prathiitsharma-cmd/Pintle-Injector-Re-Design/docs/design-guide/parts-list.jpeg

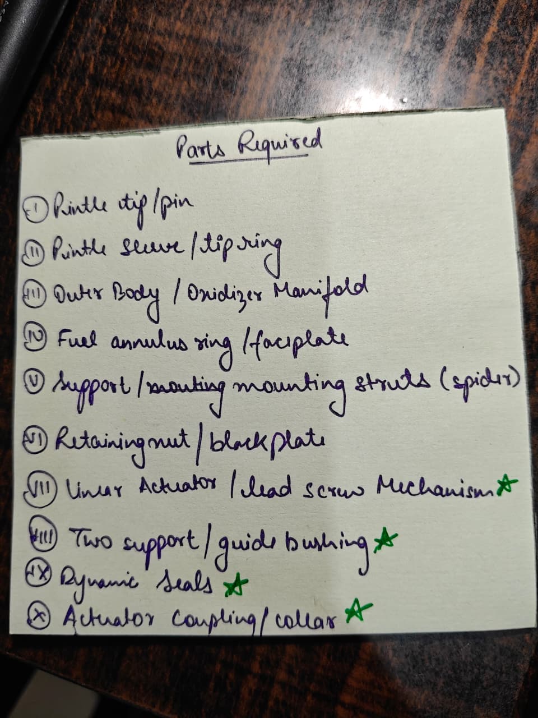
docs/design-guide/parts-list.jpeg
