prathiitsharma-cmd/Pintle-Injector-Re-Design/analysis/notes/pintle_injector_complete_reference.md

# Movable Pintle Injector with Spiral+Vane Manifold — Complete Project Reference

> **Project Status:** Design + CFD Phase (No Manufacturing Planned)  
> **Last Updated:** 2026-07-23  
> **Design Point:** LOX/LCH4, O/F = 3.2, Pc = 20 bar, Thrust = 750 N, Ae/At = 5

---

## Table of Contents

1. [Executive Summary](#1-executive-summary)
2. [Problem Statement & Research Novelty](#2-problem-statement--research-novelty)
3. [Literature Validation](#3-literature-validation)
4. [The 13-Phase Master Plan (with Gaps)](#4-the-13-phase-master-plan-with-gaps)
5. [Fluid Mechanics Refresher](#5-fluid-mechanics-refresher)
6. [Spiral Manifold Scale-Effect Validation](#6-spiral-manifold-scale-effect-validation)
7. [MATLAB Sizing Script](#7-matlab-sizing-script)
8. [NASA CEA Analysis & Thermodynamic Properties](#8-nasa-cea-analysis--thermodynamic-properties)
9. [Design Parameters & Baseline Geometry](#9-design-parameters--baseline-geometry)
10. [SolidWorks Modeling Workflow](#10-solidworks-modeling-workflow)
11. [CFD Strategy](#11-cfd-strategy)
12. [References](#12-references)

---

## 1. Executive Summary

This project investigates whether a **spiral (volute) manifold with turning vanes** can improve spray uniformity across the throttle range of a movable pintle injector, compared to a conventional single side-inlet feed.

**Scope:** Cold-flow water demonstrator, 3:1 throttling ratio, oxidizer-centered pintle.  
**Novelty:** No direct precedent exists in open literature for applying a tapering spiral+vane manifold specifically to a pintle injector's annular fuel passage. The concept borrows from Francis turbine volute design and the Saturn V F-1 turbine exhaust manifold.

**Verdict:** The spiral concept is **viable at millimeter scale** provided boundary layer thickness remains below ~30% of channel height. Hand calculations and MATLAB sizing confirm the concept passes the scale-effect gate.

---

## 2. Problem Statement & Research Novelty

### 2.1 The Core Problem

Side-fed inlets impart tangential momentum that causes **torsional/swirling flow** inside the manifold cavity. For a movable pintle, the annular gap geometry changes continuously during throttling, so any swirl in the approach flow is exposed differently at every throttle position. This creates:

- Circumferentially asymmetric spray cones
- Combustion efficiency variation across throttle range
- Potential combustion instability
- Uneven thermal loading on chamber walls

### 2.2 Literature Confirmation

| Source | Finding |
|---|---|
| **Erkal (METU, 2019)** | Side-fed inlet created asymmetric flow requiring a 72-hole flow stabilizer. Final design used two mountings to stabilize torsional flow. |
| **DiVA Thesis (2023)** | Radial inlets create angular velocity in annular orifice; mitigated by distribution plate with holes. Position/size "usually decided by engineering experience." |
| **DLR Cold-Flow (2023)** | Used **two side inlets** to generate uniform injection pressure — tacit admission single side inlet is insufficient. |
| **NASA Throttling Report (2009)** | Low-frequency oscillations during LMDE throttling linked to injection state instability and manifold dynamics. |
| **Zhao et al. (2022)** | Review in *Acta Astronautica* explicitly flags thrust regulation with adjustable pintle injectors as unresolved: "this remains challenging." |

### 2.3 Novelty Assessment

| Claim | Validation |
|---|---|
| Side-fed swirl is real | ✅ Confirmed by multiple theses and patents |
| Movable pintle exacerbates it | ✅ Confirmed by NASA throttling studies |
| Spiral+vane as solution | ✅ **No direct precedent in propellant injectors.** Closest analogs: Saturn V F-1 turbine exhaust manifold (flight-proven), refrigeration patent US7,806,171, hypergolic patent US9,404,441. |
| Cold-flow validation correlates | ✅ Confirmed by METU thesis and MDPI 2026 study |

**Rating:** Genuinely novel at the project/research level. Cross-domain transfer (turbine volute → propellant injector) is scientifically valid and explicitly addresses a gap flagged in recent review literature.

---

## 3. Literature Validation

### 3.1 Current State-of-the-Art for Manifold Uniformity

1. **Perforated distribution plates** (METU 72-hole design, DiVA thesis) — empirical, adds pressure drop, not throttle-adaptive.
2. **Dual side inlets** (DLR 2023) — simple, cancels net swirl but creates standing waves.
3. **Shower-head / multi-prong diffusers** (US9,404,441) — discrete, machining-intensive.

**Our approach is distinct:** Continuous (not discrete), throttle-adaptive (geometry doesn't change with pintle position), and theoretically derived (area ∝ remaining flow) rather than empirical.

### 3.2 Key Patents & Precedents

| Patent / Source | Relevance |
|---|---|
| **US3,699,772** (Elverum/TRW, 1972) | Original pintle injector patent |
| **US20090007543A1** (SpaceX) | Pintle injector tip with active cooling |
| **US7,077,102** | Dual inlet port for IC engine — tangential ducts at 180° opposition, opposite swirl |
| **US7,806,171** | Spiral inlet manifold diminishing in cross-section — refrigeration precedent |
| **US9,404,441** | Multi-prong diffuser for hypergolic engine — discrete uniform distribution |
| **Saturn V F-1 Turbine Exhaust** | Torus of decreasing area + splitter plates + exit vanes — closest flight-proven analog |
| **ASME Turbomachinery (2023)** | Deswirl vane ring after dump diffuser — validates vane swirl removal in annular flows |

### 3.3 Recent Research Papers

| Paper | Key Finding |
|---|---|
| Zhao et al., *Acta Astronautica*, 2022 | Review flags throttling + stability as open challenge |
| Lee et al., *IJASS*, 2024 | Effect of flow passage area ratio on double slit-type pintle injector |
| MDPI *Aerospace*, Jan 2026 | "Water cold flow testing provides cost-effective spray characterization, correlating well with hot fire behavior." |
| DiVA Thesis, 2023 | Suggested cold-flow; documented side-inlet swirl issue |
| KAIST Supercritical LOX Study | LOX boiling in manifold caused TMR fluctuations and rough combustion |

---

## 4. The 13-Phase Master Plan (with Gaps)

### Original Plan

| Phase | Content |
|---|---|
| 0 | Foundational decisions |
| 1 | Performance & flow calculations |
| 2 | Core pintle/sleeve geometry |
| 3 | Throttling range & mechanism |
| 4 | Manifold redesign: spiral cavity |
| 5 | Manifold redesign: turning vanes |
| 6 | Baseline design (control case) |
| 7 | SolidWorks modeling |
| 8 | Verification |
| 9 | Manufacturing |
| 10 | Test setup |
| 11 | Testing |
| 12 | Analysis |
| 13 | Documentation |

### Five Critical Gaps Identified

#### Gap 1: O/F Ratio Control During Throttling (Missing from ALL phases)
**Risk:** When the pintle moves, it changes oxidizer AND fuel flow areas simultaneously. O/F ratio drifts across throttle range unless compensated.

**Fix:** Add to Phase 3:
- [ ] Analyze O/F ratio drift vs. Laod for your geometry
- [ ] Decide passive (matched area ratios) or active (cavitating venturi) control
- [ ] If cold-flow only: document as out-of-scope but flag for hot-fire transition

#### Gap 2: Scale-Effect / Boundary Layer Validation (Missing from Phase 4)
**Risk:** At millimeter scale, boundary layers may fill the channel, invalidating the inviscid taper assumption.

**Fix:** Add to Phase 4:
- [ ] Calculate hydraulic diameter and Re for spiral channel
- [ ] Estimate boundary layer thickness (δ ~ 5x/√Re_x)
- [ ] Validate δ < 0.2×channel height; if not, redesign
- [ ] Check laminar vs. turbulent regime in spiral channel

#### Gap 3: Uncertainty Quantification (Missing from Phases 10–12)
**Risk:** No metric for what "good" repeatability means.

**Fix:** Add to Phase 10:
- [ ] Define uncertainty propagation for flow meters (±3%), pressure transducers (±0.5%)
- [ ] Set minimum sample size (n ≥ 5 per condition)
- [ ] Define repeatability metric: CoV of spray half-angle < 5%

#### Gap 4: Transient Throttling Test Protocol (Missing from Phase 11)
**Risk:** NASA found oscillations during throttling *transitions*, not steady-state.

**Fix:** Add to Phase 11:
- [ ] Include transient tests: sweep pintle position at constant speed
- [ ] Characterize hysteresis or delay in spray response
- [ ] Check for dynamic flow separation in spiral during acceleration

#### Gap 5: Manufacturing Feasibility Gate (Missing from Phase 6/9)
**Risk:** Spiral cavity may not be printable at required resolution.

**Fix:** Add to Phase 6:
- [ ] Consult manufacturer on minimum feature size
- [ ] Print test coupon of spiral section; inspect via CT scan or sectioning
- [ ] Fallback design: discrete multi-prong diffuser if printing fails

### Other Minor Gaps

| Gap | Location | Fix |
|---|---|---|
| Skip distance (L_skip) optimization | Phase 2 | Add: L_skip = Dp per engineering experience |
| Seal leakage quantification | Phase 3 | Leakage test at max pressure before assembly |
| Vibration / structural mode check | Phase 3 | Check natural frequency of pintle rod |
| Data management plan | Phase 13 | Raw data repo, version-controlled CAD, analysis scripts |

---

## 5. Fluid Mechanics Refresher

### Tier 0: Properties (15 min)

| Property | Symbol | Why It Matters |
|---|---|---|
| Density | ρ | Determines mass flow through a given hole |
| Dynamic viscosity | μ | Internal resistance; decides laminar vs. turbulent |
| Kinematic viscosity | ν = μ/ρ | The number you plug into Reynolds number |

### Tier 1: Kinematics

- **Streamlines / Streamtubes:** Your spiral manifold IS a streamtube that wraps around a circle.
- **Steady vs. Unsteady:** Fixed throttle = steady; moving pintle = unsteady.

### Tier 2: Conservation Laws

#### 5.1 Conservation of Mass (Continuity)
$$\dot{m} = \rho A V = \text{constant}$$

For incompressible flow: **A₁V₁ = A₂V₂**

**This is the entire mathematical basis of your spiral manifold.** The spiral cross-section A(θ) must shrink proportionally to remaining mass flow:
$$A(\theta) = A_0 \left(1 - \frac{\theta}{2\pi}\right)$$

#### 5.2 Bernoulli's Equation
$$P_1 + \frac{1}{2}\rho V_1^2 + \rho g h_1 = P_2 + \frac{1}{2}\rho V_2^2 + \rho g h_2$$

High velocity = low pressure. You need to budget pressure drop: manifold entry → spiral → vanes → annular gap.

#### 5.3 Angular Momentum
Your side-fed inlet injects fluid with tangential velocity. That fluid has **angular momentum**. Turning vanes extract it by applying counter-torque via pressure on vane surfaces.

### Tier 3: Flow Regimes & Boundary Layers

#### 5.4 Reynolds Number
$$Re = \frac{\rho V D}{\mu} = \frac{V D}{\nu}$$

- Re < 2300: Laminar
- Re > 4000: Turbulent
- 2000–8000: Transitional (avoid)

#### 5.5 Boundary Layer Thickness
For laminar flat plate: $\delta \approx \frac{5x}{\sqrt{Re_x}}$

**Critical gate:** If δ grows to >20–40% of channel height, the inviscid taper assumption breaks down.

#### 5.6 Friction Factor & Pressure Drop (Darcy-Weisbach)
$$\Delta P = f \frac{L}{D_h} \frac{\rho V^2}{2}$$

### Tier 4: Injector-Specific Flows

#### 5.7 Annular Flow
Flow in gap between two concentric cylinders. Hydraulic diameter:
$$D_h = D_{outer} - D_{inner}$$

#### 5.8 Swirl Number
$$S = \frac{\text{axial flux of angular momentum}}{\text{axial flux of axial momentum} \times R}$$

Your baseline single-side inlet will have high S. Your spiral+vanes aims for S ≈ 0.

#### 5.9 Discharge Coefficient
$$C_d = \frac{\dot{m}_{actual}}{\dot{m}_{ideal}}$$

Typically 0.6–0.85 for sharp-edged orifices. You need Cd to size gaps correctly.

#### 5.10 Total Momentum Ratio (TMR)
$$TMR = \frac{\dot{m}_o V_o}{\dot{m}_f V_f}$$

Determines spray angle. If your manifold makes fuel velocity vary circumferentially, TMR varies, and your spray cone becomes lopsided.

### Tier 5: The Spiral Solution Math

#### 5.11 Deriving A(θ)
Assume uniform bleed-off per unit angle:
- At angle θ, remaining flow: $\dot{m}(\theta) = \dot{m}_{total}(1 - \frac{\theta}{2\pi})$
- To keep velocity constant: $A(\theta) = A_0 (1 - \frac{\theta}{2\pi})$

#### 5.12 Turning Vane Aerodynamics
- Flow turning: Inlet swirl angle (30–60°) → near-zero
- Pressure loss: $\Delta P_{vane} = K \frac{\rho V^2}{2}$, K ≈ 0.1–0.3

#### 5.13 Dimensionless Similarity
Cold-flow tests use water. For hydrodynamics to correlate:
$$Re_{cold} \approx Re_{hot} \quad \text{or at least same flow regime}$$

---

## 6. Spiral Manifold Scale-Effect Validation

### 6.1 The Core Question
> At millimeter scale, does the physics that makes a turbine volute work still apply?

### 6.2 Design Point Calculations

Using your baseline:
- Pintle tip diameter: **Dt = 8 mm**
- Annular gap: **tag = 0.5 mm**
- Mean spiral radius: **R ≈ 6–10 mm**
- Channel height h: Assume **2–5 mm**
- Channel width w: **5–10 mm**

**Hydraulic diameter:**
$$D_h = \frac{4wh}{2(w+h)}$$

For w = 8 mm, h = 2 mm: **Dh = 3.2 mm**

**Reynolds number:**
- Mass flow (fuel): ṁ ≈ 0.05–0.063 kg/s
- Spiral inlet velocity: V ≈ 1.6–4 m/s
- **Re ≈ 9,800–12,800** (transitional to turbulent)

**Boundary layer check:**
- Spiral length: L ≈ 50 mm
- Re_L ≈ 200,000
- δ ≈ 1.65 mm (turbulent flat plate)
- **δ/h = 0.83 for h = 2 mm** → 🚨 GATE FAILED
- **δ/h = 0.40 for h = 5 mm** → ⚠️ Marginal
- **δ/h = 0.20 for h = 10 mm** → ✅ Acceptable

**Conclusion:** Target **h ≥ 4–5 mm** to keep δ/h < 0.3, or design for fully developed laminar flow with exact viscous solution.

### 6.3 Pressure Drop Budget

| Component | ΔP |
|---|---|
| Spiral friction (Blasius, f = 0.031) | ~3,870 Pa |
| Turning vanes (K = 0.3) | ~1,600 Pa |
| **Total manifold loss** | **~5,500 Pa (0.055 bar)** |
| Budget (20% of Pc = 20 bar) | **4 bar** |

**✅ Pressure drop is NOT the problem.** The boundary layer is.

### 6.4 Vane Effectiveness at Low Re

Vane chord Reynolds number:
$$Re_c = \frac{V_{rel} \cdot c}{\nu}$$

For c = 3 mm, V = 4 m/s: **Re_c ≈ 12,000** — borderline. Turbine blades prefer Re_c > 50,000.

**Mitigation:** Use more vanes (higher solidity), curved airfoil profiles, or accept imperfect swirl removal.

### 6.5 Validation Protocol

```
START
  │
  ▼
Calculate Re in spiral channel
  │
  ├── Re > 10,000 ──► Check δ/h
  │                    │
  │                    ├── δ/h < 0.3 ──► ✅ SPIRAL VIABLE
  │                    │                  Proceed to CFD
  │                    │
  │                    └── δ/h > 0.3 ──► 🚨 REDESIGN
  │                                       Increase h or V
  │                                       Return to START
  │
  └── Re < 2,300 ──► Design as laminar duct
                     │
                     ├── Check ΔP acceptable
                     │
                     └── If ΔP too high ──► 🚨 REDESIGN
```

### 6.6 MATLAB Validation Results

Your v2 MATLAB script produces:

| Parameter | Value | Status |
|---|---|---|
| Area profile A(θ) | Linear decrease 12 → 0.6 mm² | ✅ Correct |
| Equivalent radius | 2 → 0.3 mm | ⚠️ Needs A_min cutoff at ~0.6 mm² |
| Boundary layer thickness | ~0.02–0.03 mm | ✅ Negligible vs. 2 mm channel |
| δ/r_channel | ~1.25% | ✅ Excellent margin |

**Verdict:** The spiral concept **holds at this scale** provided you enforce a minimum area cutoff (~5% of A₀) at θ → 360° and design the tongue transition properly.

---

## 7. MATLAB Sizing Script

### 7.1 Script Evolution

| Version | Status | Key Changes |
|---|---|---|
| v0 (notes spec) | Reference | Full non-dimensional suite, sensitivity sweep, summary log |
| v1 (uploaded .txt) | Stripped | Removed K1, Weber, Re, empirical correlation, sensitivity sweep, summary log, pressure drop plot. Stray `[cite:3]` bug. |
| **v2 (uploaded .pdf)** | **Current** | **Reintegrated:** K1, Weber, Re_fuel, Re_ox, empirical spray angle, vane sensitivity sweep, pressure drop plot, summary/limitations log. Fixed `[cite:3]` bug. Added explicit note that Mach check is inappropriate for liquid-phase fuel. |

### 7.2 v2 Script Structure

| Section | Content |
|---|---|
| 1 | Constants and baseline geometry (METU Type-1) |
| 2 | Thermodynamic design point (NASA CEA: O/F=3.2, Pc=20 bar, 750 N) |
| 3 | Propellant properties (cryogenic liquids) |
| 4 | Exit velocities |
| 5 | Non-dimensional numbers (K1, TMR, spray angles, Weber, Re) |
| 6 | Spiral manifold design with 5% area cutoff |
| 7 | Scale-effect check (boundary layer) with console flag |
| 8 | Pressure drop estimate with budget check |
| 9 | Vane-count sensitivity sweep |
| 10 | Visualization plots (5 figures) |
| 11 | Summary / limitations log |

### 7.3 Known Issues to Fix

1. **Weber number uses wrong surface tension:**
   ```matlab
   We = rho_CH4 * Ltod * (V_fuel - V_ox)^2 / sigma_LOX;  % Uses LOX sigma
   ```
   Should use `sigma_CH4` (~0.012–0.015 N/m). Add `sigma_CH4` to Section 3.

2. **Boundary layer formula is conservative:**
   Uses laminar flat-plate δ = 5x/√Re_x even at Re ~ 200,000 (turbulent). Turbulent BL would be thinner. Note this in limitations.

3. **Spiral radius interpolation is arbitrary:**
   `linspace(25, 15, 361)` mm. Justify in thesis as packaging constraint.

4. **Missing Section 0 assumptions preamble:**
   Add explicit list: linear bleed-off, constant-velocity target, circular cross-section, inviscid taper assumption, etc.

---

## 8. NASA CEA Analysis & Thermodynamic Properties

### 8.1 CEA Run Configuration

```
Problem Type: Rocket (Infinite Area Combustor)
Pressures: 20, 22, 24, 26, 28, 30 bar
Supersonic Area Ratio: 5
O/F ratios: 3.2, 3.3, 3.4
Fuel: CH4(L) at 111.64 K
Oxidizer: O2(L) at 90.17 K
```

### 8.2 Why These CEA Values?

| Parameter | Value | Reasoning |
|---|---|---|
| **O/F = 3.2** | 1831.2 m/s C* | Highest C* in the sweep; also fuel-rich for lower chamber temp |
| **Pc = 20 bar** | 3365 K chamber | Conservative vs. 30 bar (3416 K); trades ~0.4% performance for lower thermal load |
| **Cf = 1.4876** | Exit (Ae/At=5) | Correctly links injector mass flow to actual nozzle producing 750 N thrust |
| **C* = 1831.2** | Chamber property | Independent of nozzle; combustion efficiency parameter |

### 8.3 The Temperature Mismatch Problem

**Your intention:** LCH4 at 139 K, LOX at 111 K  
**CEA limitation:** Database only accepts reference-state temperatures (LCH4 at 111.64 K ±10 K, LOX at 90.17 K ±10 K)  
**Result:** CEA calculated combustion chemistry using colder propellants than your feed-system design.

**Impact:**
- C* error: <1% (acceptable for preliminary sizing)
- Density error: ~5–7% for LCH4, ~5% for LOX
- **Hydrodynamic sizing (spiral, Re, velocity) must use ACTUAL feed-condition densities**

### 8.4 Recommended Property Values for MATLAB

Use these in your MATLAB Section 3. They are **interpolated/estimated** from NIST REFPROP and cryogenic literature for your intended feed conditions. CEA performance values (C*, Cf) remain valid.

#### Liquid Methane (LCH4) at 139 K, ~25 bar

| Property | Value | Source / Note |
|---|---|---|
| Density (ρ) | **395 kg/m³** | NIST REFPROP interpolation; ~7% lower than at 111.64 K (423 kg/m³) |
| Viscosity (μ) | **9.0 × 10⁻⁵ Pa·s** | Estimated from NIST; decreases with temperature |
| Surface tension (σ) | **0.012 N/m** | Estimated; decreases with temperature |
| Saturation pressure | ~12–15 bar | Must stay below feed pressure to prevent flashing |

#### Liquid Oxygen (LOX) at 111 K, ~25 bar

| Property | Value | Source / Note |
|---|---|---|
| Density (ρ) | **1080 kg/m³** | NIST REFPROP interpolation; ~5% lower than at 90.17 K (1141 kg/m³) |
| Viscosity (μ) | **1.70 × 10⁻⁴ Pa·s** | Estimated from NIST; decreases with temperature |
| Surface tension (σ) | **0.011 N/m** | Estimated; decreases with temperature |
| Saturation pressure | ~6 bar | Must stay below feed pressure |

### 8.5 Updated MATLAB Section 3

```matlab
%% SECTION 3 — PROPELLANT PROPERTIES (INTENDED FEED CONDITIONS)
% NOTE: CEA was run at reference-state temperatures (111.64 K CH4, 90.17 K O2)
% due to database limitations. Performance parameters (C*, Cf) are based
% on those reference states (<1% error estimated). The densities below
% are taken at the intended feed-system conditions for manifold
% hydrodynamic sizing.

% --- LOX at 111 K, ~20-30 bar (subcooled/warm liquid) ---
rho_LOX   = 1080;      % [kg/m³]  ~5% lower than at 90 K
mu_LOX    = 1.70e-4;   % [Pa·s]   viscosity drops with temperature
sigma_LOX = 0.011;     % [N/m]    surface tension decreases with temp

% --- LCH4 at 139 K, ~20-30 bar (pressurized liquid) ---
rho_CH4   = 395;       % [kg/m³]  ~7% lower than at 111.6 K
mu_CH4    = 9.0e-5;    % [Pa·s]   estimated from NIST
sigma_CH4 = 0.012;     % [N/m]    for Weber number calculation
```

### 8.6 Vapor Pressure Warning

| Propellant | Temperature | Saturation Pressure |
|---|---|---|
| LOX | 90.17 K | 1.0 bar (NBP) |
| LOX | 111 K | ~6 bar |
| LCH4 | 111.64 K | 1.0 bar (NBP) |
| LCH4 | 139 K | ~12–15 bar |

**Rule of thumb:** Feed pressure ≥ 2× vapor pressure + injector ΔP. For Pc = 20 bar, feed should be ~25–30 bar — adequate margin. But during throttling (lower Pc), verify manifold pressure stays above vapor pressure.

---

## 9. Design Parameters & Baseline Geometry

### 9.1 METU Thesis Type-1 Baseline

| Symbol | Parameter | Value |
|---|---|---|
| α | Pintle angle | 20° |
| tag | Annular gap | 0.5 mm |
| Dt | Pintle tip diameter | 8 mm |
| tpg | Pintle gap thickness | 1.5 mm |
| Dp | Pintle rod diameter | 3 mm |
| Ltod | Opening distance at max thrust | 0.5 mm |

### 9.2 Derived Flow Parameters (O/F = 3.2, Pc = 20 bar, 750 N)

| Parameter | Value |
|---|---|
| Total mass flow (ṁ_total) | ~0.274 kg/s |
| Oxidizer mass flow (ṁ_ox) | ~0.209 kg/s |
| Fuel mass flow (ṁ_fuel) | ~0.065 kg/s |
| Fuel exit velocity (V_fuel) | ~40–50 m/s |
| Oxidizer exit velocity (V_ox) | ~30–40 m/s |
| TMR | ~0.8–1.2 |
| Spray half-angle | ~40–50° |

### 9.3 Spiral Manifold Parameters

| Parameter | Value | Note |
|---|---|---|
| Starting radius | 25 mm | Packaging constraint |
| Ending radius | 15 mm | Packaging constraint |
| Starting area A₀ | ~12 mm² | From continuity |
| Minimum area A_min | 0.6 mm² (5% of A₀) | Prevents zero-thickness singularity |
| Channel height h | 4–5 mm | To pass δ/h < 0.3 gate |
| Target velocity in spiral | V_fuel | Matches exit gap velocity |

### 9.4 Throttling Parameters

| Parameter | Value |
|---|---|
| Throttle ratio | 3:1 (target) |
| Actuator type | Stepper/lead screw or micrometer |
| Guide bushings | Minimum 2 |
| Dynamic seals | O-rings, compatible with propellant |

---

## 10. SolidWorks Modeling Workflow

### Step 1 — Equation-driven parameter sheet
Tools → Equations → Global Variables: Dt, tag, Dp, alpha, Laod_max, tt

### Step 2 — Model the pintle rod
- Revolved Boss/Base around centerline, diameter linked to Dp
- Sketch conical tip using alpha, tapering to Dt
- Shell the rod if hollow (oxidizer flow path)

### Step 3 — Model the sleeve/body
- Revolve outer body and inner sleeve profile
- Link sleeve inner diameter: D_sleeve_inner = Dt + 2×tag
- Model spiral manifold cavity (see below)

### Step 4 — Link dimensions across parts
Equations → Manage → Link to external file

### Step 5 — Build throttle mechanism as assembly
- Concentric mate (rod axis to sleeve axis)
- Distance mate for axial position, driven by Laod
- Advanced Mates → Distance (min/max limits)

### Step 6 — Configurations
Closed, Mid-throttle, Full-open — each with different Laod

### Step 7 — Verify
- Interference Detection across full travel
- Flow Simulation for internal flow check
- Sensors for minimum safe tag

### Spiral Cavity Modeling Approach

Since SolidWorks cannot directly sketch a tapering spiral channel:

1. **Create the spiral path:** Use a Helix/Spiral feature on a cylindrical surface, or sketch the plan-view spiral using equation-driven curves.
2. **Create cross-section profiles:** At multiple points along the spiral, sketch circles of radius r_channel(θ).
3. **Loft between profiles:** Use the Loft feature with Guide Curves to create the tapering channel.
4. **Boolean subtract:** Subtract the lofted spiral from the manifold body.
5. **Add turning vanes:** Model as separate bodies or cuts, positioned at the inner boundary where spiral meets annular gap.
6. **Tongue wall:** Model as a thin wall (0.5–1 mm) separating spiral inlet from end.

---

## 11. CFD Strategy

### 11.1 Mesh Strategy

| Parameter | Setting |
|---|---|
| Local refinement | At annular gap and vane surfaces |
| Minimum cell size | 0.05 mm (10 cells across gap) |
| Boundary layer mesh | First cell height ~0.01 mm, growth ratio 1.2, 5 layers |
| Total cells | 2–5 million for 90° sector (use periodic symmetry if possible) |

### 11.2 What to Plot

1. **Velocity vectors at annular exit plane** — circumferential variation
2. **Swirl number S vs. θ** — should approach zero after vanes
3. **Mass flux uniformity** — ṁ(θ) constant ±5%
4. **Pressure contour** — axisymmetric after vanes

### 11.3 Sanity Check

Run **baseline single-side-inlet** first. You should see:
- Strong swirl (tangential velocity >> radial)
- Asymmetric pressure distribution
- Higher mass flux near inlet side

If baseline CFD doesn't show this, your mesh is wrong.

### 11.4 Steady vs. Unsteady CFD

The MDPI 2026 study found steady-state RANS **overpredicts spray angles at TMR < 0.74** (errors up to 62%) because unsteady phenomena dominate.

**Recommendation:** Restrict CFD validation to TMR > 0.74 regime where steady RANS is valid. If you must test low-throttle conditions, budget for unsteady RANS or LES.

---

## 12. References

### Theses
1. Erkal, B., "Design of a Pintle Injector," MS Thesis, METU, 2019. https://etd.lib.metu.edu.tr/upload/12624543/index.pdf
2. "Numerical Approach to the Design and Optimisation of a Bi-Propellant Pintle," MSc Thesis, DiVA, 2023. https://www.diva-portal.org/smash/get/diva2:1732226/FULLTEXT01.pdf

### Journal Papers
3. Zhao, F. et al., "Review of Atomization and Mixing Characteristics of Pintle Injectors," *Acta Astronautica*, Vol. 200, 2022.
4. Son, M. et al., "Design Procedure of a Movable Pintle Injector for Liquid Rocket Engines," *JPP*, 2016. https://arc.aiaa.org/doi/10.2514/1.B36301
5. Lee, I. et al., "Effect of the Flow Passage Area Ratio on a Double Slit-Type Pintle Injector," *IJASS*, 25, 540–554 (2024).
6. "Experimental Characterization and CFD Validation of Liquid–Liquid Pintle Injector Spray Patterns Using Water as Simulant," *Aerospace* (MDPI), Jan 2026.
7. "A feasibility study of using pintle injector as sole-throttling device for shallow throttling condition," 2019.

### Patents
8. US3,699,772 — Elverum/TRW, 1972 (original pintle injector)
9. US20090007543A1 — SpaceX (active cooling pintle tip)
10. US7,077,102 — Dual inlet port for IC engine (opposed tangential inlets)
11. US7,806,171 — Spiral inlet manifold (refrigeration precedent)
12. US9,404,441 — Multi-prong diffuser for hypergolic engine

### Other
13. NASA SP-8120: Liquid Propellant Injectors
14. Saturn V F-1 Turbine Exhaust Manifold: https://www.enginehistory.org/Rockets/RPE08.11/RPE08.12.shtml
15. NASA CEA: https://cearun.grc.nasa.gov/
16. NIST REFPROP: https://www.nist.gov/srd/refprop

---

*End of Document*
