prathiitsharma-cmd/Pintle-Injector-Re-Design/docs/report/main_preview.pdf

# Preliminary Analytical Design and Feasibility Study of a Spiral–Vane Manifold for a Throttling LOX/LCH4 Pintle Injector

## Technical Report

Submitted by

## Prathit Sharma

B.Tech. Mechanical Engineering

Indian Institute of Petroleum and Energy

August 2026

Preliminary Analytical Design of a Spiral-Vane Pintle Injector Manifold | i

## Abstract

Movable pintle injectors used in deep-throttling liquid rocket engines commonly feed the outer (fuel) annulus through a single side-port inlet, a geometry known to impart tangential momentum and produce circumferentially non-uniform, swirling flow. Because the annular gap geometry itself changes continuously as the pintle throttles, this swirl is exposed differently at every throttle position, degrading spray symmetry and combustion uniformity. This report documents the preliminary, pre-CAD analytical design phase of an internship project investigating whether a spiral (volute) manifold combined with a ring of turning vanes – a geometry adapted from turbomachinery volute casings – can enforce uniform circumferential flow in a millimetre-scale LOX/LCH4 pintle injector manifold. A thermodynamic design point (O/F = 3.2, Pc = 20 bar, thrust = 750 N) was established using the NASA-Glenn Chemical Equilibrium with Applications (CEA) code, and a baseline pintle/sleeve geometry was adopted from a validated literature design. A MATLAB sizing script was developed to derive the spiral cross-sectional area profile from mass conservation, evaluate the governing non-dimensional numbers (Reynolds number, Weber number, Total Momentum Ratio), check the scale-effect (boundary-layer) validity of the spiral concept at millimetre scale, and estimate the manifold pressure-drop budget. The analysis indicates that the spiral concept passes its scale-effect gate (minimum channel-toboundary-layer margin of 0.43 mm) and remains comfortably within the pressure-drop budget (0.41 bar against a 4.0 bar allowance), motivating progression to CAD modelling and CFD verification, which lie outside the scope of this report.

Preliminary Analytical Design of a Spiral-Vane Pintle Injector Manifold | ii

## Contents

1 Introduction | 1
2 Literature Review | 2
3 Theoretical Background | 2
4 Methodology | 4
5 Calculations and Results | 6
6 Discussion | 9
7 Conclusion and Future Work | 11
A Master Parameter Summary | 14

Preliminary Analytical Design of a Spiral-Vane Pintle Injector Manifold | iii

## List of Figures

1 | Required spiral cross-sectional area (top) and equivalent circular channel radius
| (bottom) as a function of angular position θ, stopping at the 5% area floor near
| θ = 360◦
| | | 7
2 | Plan-view outer-wall envelope of the spiral manifold, generated using a place-
| holder linear radius taper (25 mm → 15 mm) for path-length estimation only. . . | 8
3 | Scale-effect check: channel radius, (conservatively estimated, laminar-flat-plate)
| boundary-layer thickness, and resulting margin, as a function of angular position. | 9
4 | Manifold pressure-drop breakdown (friction and vane minor loss) against the
pressure-drop budget | 10

5 Total manifold pressure drop vs. number of turning vanes (crude placeholder loss
model), against the 4.0 bar budget | 12

## List of Tables

1 | Thermodynamic design point (NASA CEA) | | 4
2 | Baseline pintle/sleeve geometry, adopted from Erkal [5], Table 3.1, Injector Type-1. 5
3 | Propellant properties at feed conditions (NIST Chemistry WebBook [12]) | | 5
4 | Mass flow rates and exit velocities | | 6
5 | Non-dimensional numbers and spray angle estimates | | 6
6 | Manifold pressure drop estimate vs. budget | | 8
7 | Vane-count sensitivity (crude placeholder loss model) | 11
8 | Master parameter summary – analytical design phase | 14

Preliminary Analytical Design of a Spiral-Vane Pintle Injector Manifold | 1

## 1 Introduction

### 1.1 Background and Motivation

In variable-thrust liquid rocket engines, the pintle injector is a single, centrally located injection element that replaces the many discrete orifices of a conventional injector faceplate. First patented by G.W. Elverum of TRW in 1971 [1] and flown on the Apollo Lunar Module descent engine, the pintle injector remains a common choice for deep-throttling applications because of its favourable combustion-stability characteristics and its ability to vary injection area continuously by translating a central pintle rod within a fixed sleeve [2, 3]. A comprehensive review of the pintle injector’s heritage and operating characteristics is given by Dressler and Bauer [2].

In a typical pintle injector, one propellant (often the oxidizer) is fed down the centre of the pintle rod and discharged radially at the tip, while the second propellant (often the fuel) is fed into an annular cavity surrounding the pintle tip and discharged axially through a thin annular gap. When this annular cavity – the manifold – is fed from a single side-port inlet, the incoming flow carries tangential momentum into the cavity, producing torsional swirl rather than the uniform circumferential distribution required for a symmetric spray fan. For a movable pintle, this problem is compounded: as the annular gap width changes with throttle position, the same manifold swirl is exposed to a different flow condition at every throttle setting, so any asymmetry cannot simply be tuned out at one operating point.

### 1.2 Problem Statement

The specific engineering question addressed by this project is whether a spiral (volute) manifold – a tapering, self-similar cavity geometry conventionally used in turbomachinery casings (e.g. Francis turbine volutes, pump casings) to distribute or collect flow uniformly around a circumference – can be adapted to the millimetre-scale annular manifold of a pintle injector, and whether adding a ring of turning vanes at the manifold–annulus interface can remove residual tangential momentum before the flow reaches the injection gap. The working hypothesis is that sizing the spiral’s cross-sectional area to shrink in proportion to the flow already bled off around its circumference (a direct consequence of mass conservation) will yield a substantially more uniform exit velocity than a plain single-side-inlet cavity.

### 1.3 Objectives and Scope of This Report

The objectives of the internship project, in full, span thermodynamic sizing, manifold geometry derivation, CAD modelling of both a spiral+vane and a baseline (single-side-inlet) manifold, CFD verification, cold-flow manufacture, and experimental testing. This report documents only the first, analytical phase of that project – the thermodynamic design point, baseline injector geometry, spiral manifold sizing, non-dimensional flow checks, and pressure-drop budget – all of which were completed using NASA CEA and a custom MATLAB sizing script, prior to any CAD or CFD work. CAD modelling, CFD simulation, manufacturing, and testing are identified as future work in Section 7 but are not otherwise detailed here, since they had not yet been carried out at the time of writing.

Preliminary Analytical Design of a Spiral-Vane Pintle Injector Manifold | 2

## 2 Literature Review

The pintle injector’s origin traces to a coaxial-pintle reactant injector patented by Elverum of TRW in 1971 [1]; Dressler and Bauer [2] document its subsequent heritage across engines ranging from 10 N thrusters to the 3-meganewton-class Low-Cost Pintle Engine, and attribute its popularity in throttling applications to combustion-stability characteristics inherent to its flowfield. Nardi Rezende et al. [3] present experimental results from building and testing pintle injector prototypes, discussing how the key geometric parameters (annular gap, pintle tip diameter, skip distance) govern propellant mass flow split and are used to control the injector’s operating point.

A formal, spray-characteristic-driven design procedure for movable pintle injectors is given by Son et al. [4], who derive the spray half-angle and Sauter mean diameter as functions of the Total Momentum Ratio (TMR) and a characteristic number relating the fuel-side and oxidizer-side velocities and gap dimensions. Erkal’s thesis [5] builds directly on this methodology, presenting a validated baseline geometry (pintle angle, annular gap, tip diameter, pintle rod diameter) for a Type-1 injector design; that baseline geometry is adopted directly in the present work (Section 4.2) so that any measured or predicted difference between manifold configurations can be attributed to the manifold design rather than to a re-sized pintle tip.

Propellant choice is directly informed by Vasques and Haidn [6], who study the effect of pintle injector element geometry on combustion specifically for a liquid oxygen/liquid methane (LOX/LCH4) engine – the same propellant combination used in this project – and report that geometric parameters strongly influence combustion performance for this propellant pair. More recently, Cha, Andersson and Bohlin [7] present a numerical optimization of a pintle injector for a deep-throttleable LOX/GCH4 engine using convex quadratic programming over spray angle, vaporization distance, and Sauter mean diameter, underlining that pintle injector design for throttling applications involves a genuinely multi-parameter optimization rather than a single closed-form solution. Rajendran et al. [8] provide a broader design-and-optimization treatment of pintle injectors for liquid rocket engines, while Sanjit et al. [9] discuss the coaxial-swirl injector as an alternative atomization architecture, offering a useful point of contrast to the pintle injector’s own atomization mechanism (impingement-driven rather than swirl-driven breakup).

None of the pintle-specific studies reviewed here explicitly analyse circumferential non-uniformity arising from a single side-fed manifold inlet, nor do they propose a volute-style manifold correction. This gap – between well-established pintle sizing methodology on one hand, and manifoldlevel flow distribution on the other – motivates the analytical investigation documented in this report.

## 3 Theoretical Background

### 3.1 Conservation of Mass and the Spiral Area Profile

The spiral manifold’s sizing rests entirely on the steady, incompressible continuity relation

m˙ = ρAV = constant. | (1)

If fluid is assumed to bleed off the spiral cavity uniformly per unit angle θ travelled around the circumference, the flow remaining inside the cavity at angle θ is

m˙ (θ) = ˙mfuel
1 −

θ
2π
, | (2)

Preliminary Analytical Design of a Spiral-Vane Pintle Injector Manifold | 3

and, to hold the local velocity constant (the target uniformity condition adopted for this design), the required local cross-sectional area is

A(θ) = m˙ (θ)

ρ Vtarget

= A0

1 −

θ
2π
, | (3)

where A0 is the area at the inlet (θ = 0). Equation 3 would drive the area to zero at θ = 2π, which is not physically realizable (it would collapse the manifold to a zero-thickness slit and crash any downstream meshing); a 5% minimum-area floor, Amin = 0.05 A0, is therefore imposed near the end of the spiral.

### 3.2 Reynolds Number and Boundary-Layer Thickness

The local Reynolds number in the spiral channel is

Re =

ρV Dh
µ
, | (4)

where Dh is the hydraulic diameter of the (assumed circular, for a first-pass estimate) channel cross-section. To provide a conservative scale-effect check, the laminar flat-plate boundary-layer growth relation
δ ≈

5x
√
Rex

(5)

is applied even though the local Reynolds numbers in this design are firmly in the turbulent regime (Re ∼ 10⁵
); because a turbulent boundary layer grows more slowly with distance than this laminar estimate, using the laminar formula deliberately overestimates δ and therefore underestimates the available margin – a conservative, safe-direction approximation rather than an exact prediction. The scale-effect criterion applied is that the margin rchannel−δ must remain positive (and ideally comfortably so) at every angular station; if the boundary layer were to fill the channel, the inviscid, constant-velocity assumption underlying Equation 3 would break down.

### 3.3 Pressure Drop (Darcy–Weisbach)

Frictional pressure loss along the spiral is estimated with the Darcy–Weisbach relation,

∆P = f

L
Dh

1
2

ρV ²
, | (6)

with the friction factor f taken as 64/Re in the laminar regime and via the Blasius correlation f = 0.316/Re⁰.25 in the turbulent regime. A single lumped minor-loss coefficient K is used to estimate the additional pressure drop across the turning vane ring,

∆Pvane = K

1
2

ρV ²
, | (7)

with K = 0.3 adopted as a representative flow-straightener value pending a vane geometryspecific figure. The total estimated manifold pressure drop is compared against a pressure-drop budget of 20% of chamber pressure, a standard rule of thumb for injector design.

Preliminary Analytical Design of a Spiral-Vane Pintle Injector Manifold | 4

### 3.4 Spray and Atomization Indicators

Three further non-dimensional quantities, following the methodology of Son et al. [4] and Erkal [5], are used to sanity-check the spray quality implied by the sizing:

Total Momentum Ratio (TMR), which governs spray impingement and half-angle:

TMR = | m˙ oxVox cos α

m˙ fuelVfuel + ˙moxVox sin α

, θcone = cos⁻¹

1

1 + TMR
, | (8)

where α is the pintle tip half-angle.

Characteristic number K1, relating the fuel-side and oxidizer-side exit conditions:

K1 =

Vfuel tag

Vox Ltod

. | (9)

Weber number, an atomization indicator (higher W e indicates better sheet breakup):

W e =

ρfuel Ltod (Vfuel − Vox)

2

σfuel

. | (10)

This Weber number formula is carried over from a liquid-gas correlation in the literature [5]; since both propellants in this design are liquid (LOX/LCH4), it is treated here as a qualitative “is it much greater than 1” sanity check rather than a validated liquid–liquid breakup model (see Section 6.1).

## 4 Methodology

### 4.1 Propellant Selection and Thermodynamic Design Point

Liquid oxygen (LOX) and liquid methane (LCH4) were selected as the propellant pair, consistent with recent pintle injector research for this propellant combination [6, 7], and with an oxidizercentred architecture: LOX flows down the central pintle rod and exits radially at the tip through the variable opening, while LCH4 flows through the fixed outer annular gap and exits axially.

The thermodynamic design point was obtained from the NASA-Glenn Chemical Equilibrium with Applications (CEA) code [10, 11], run for a fuel-rich mixture ratio sweep (O/F = 3.2, 3.3,
3.4) and a chamber pressure sweep (20–30 bar) at a supersonic area ratio of 5. The design point selected for sizing is summarized in Table 1.

Table 1: Thermodynamic design point (NASA CEA).

Parameter | Value
Oxidizer/Fuel ratio (O/F) | 3.2
Chamber pressure (Pc) | 20 bar
Target thrust | 750 N
Supersonic area ratio (Ae/At) 5 Characteristic velocity (C

∗
) | 1831.2 m/s
Thrust coefficient (Cf ) | 1.4876

O/F = 3.2 was selected as it produced the highest C

∗
in the sweep while remaining fuel-rich (lower chamber temperature, easier thermal management); Pc = 20 bar was selected as a

Preliminary Analytical Design of a Spiral-Vane Pintle Injector Manifold | 5

conservative choice against the higher end of the sweep, trading a small performance penalty for reduced thermal loading. The total and per-propellant mass flow rates follow directly from C

∗
, Cf and the target thrust:

m˙ total =

Thrust
C∗Cf

=

750
1831.2 × 1.4876
≈ 0.2754 kg/s, | (11)

split by the O/F ratio into ˙mox ≈ 0.2098 kg/s and ˙mfuel ≈ 0.0656 kg/s.

### 4.2 Baseline Injector Geometry

Rather than re-deriving the pintle/sleeve geometry from first principles, the Type-1 baseline geometry validated in Erkal’s thesis [5] (Table 3.1 therein) was adopted directly, so that the manifold design remains the only variable under investigation. This baseline geometry, though originally validated against a different (LOX/GCH4) design point, is treated in this report as a checked starting point rather than an unquestioned one; Sections 5 and 6.1 verify that it still produces physically sane velocities and non-dimensional numbers under the present LOX/LCH4 design point.

Table 2: Baseline pintle/sleeve geometry, adopted from Erkal [5], Table 3.1, Injector Type-1.

Symbol | Parameter | Value
α | Pintle tip half-angle | 20◦
tag | Annular gap (outer, LCH4 exit) | 0.5 mm
Dt | Pintle tip diameter | 8 mm
tpg | Pintle gap thickness | 1.5 mm
Dp | Pintle rod diameter | 3 mm
Ltod | Pintle opening distance at max thrust | 0.5 mm

The thin-annulus approximation (A ≈ πDt) is used for both exit flow areas, appropriate here since both gaps (0.5 mm) are much smaller than the corresponding diameter (8 mm).

### 4.3 Propellant Properties at Feed Conditions

CEA’s own thermodynamic database is restricted to fixed reference-state propellant temperatures (111.64 K for LCH4, 90.17 K for LOX), which differ from the intended feed-system conditions of this design (139 K / 111 K respectively, at 25 bar). Because CEA’s combustionchemistry outputs (C

∗
, Cf ) are only weakly sensitive to this difference (an estimated <1% effect), they are retained from the CEA run; however, the density used for hydrodynamic sizing of the manifold is sensitive to feed temperature and was therefore looked up separately, at the actual intended feed conditions, from the NIST Chemistry WebBook isothermal and saturation-curve fluid tables. The values used are summarized in Table 3.

Table 3: Propellant properties at feed conditions (NIST Chemistry WebBook [12]).

Propellant & state | Density ρ | Viscosity µ | Surface tension σ
LOX, 111 K, 25 bar | 1037.1 kg/m³ | 1.2216 × 10⁻⁴ Pa·s | 0.00815 N/m
LCH4, 139 K, 25 bar | 381.88 kg/m³ | 7.103 × 10⁻⁵ Pa·s | 0.00774 N/m

Surface tension values are taken from NIST’s saturation-curve table (tabulated as a function of temperature alone at each fluid’s own saturation pressure – 5.82 bar for LOX at 111 K, 6.09 bar

Preliminary Analytical Design of a Spiral-Vane Pintle Injector Manifold | 6

for LCH4 at 139 K – rather than at 25 bar), used as a proxy for the compressed-liquid value since surface tension is only weakly pressure-dependent this far from each fluid’s critical point.

### 4.4 Analytical Sizing Tool

A MATLAB script was developed to carry the design point and baseline geometry of Sections 4.1–4.3 through to a spiral manifold size, a set of non-dimensional spray-quality checks, a scale-effect (boundary-layer) validation, and a pressure-drop estimate. The script is organized into eleven sections: constants and baseline geometry; the thermodynamic design point; propellant properties; exit velocities; non-dimensional numbers; spiral manifold area profile (with the 5% area floor); the scale-effect check; the pressure-drop estimate; a vane-count sensitivity sweep; visualization; and a summary/limitations log. Every quantitative result in Section 5 is drawn directly from this script’s output.

## 5 Calculations and Results

### 5.1 Mass Flow Split and Exit Velocities

Using the exit areas from the thin-annulus approximation (Afuel = πDttag, Aox = πDtLtod) together with the mass flow split and propellant densities of Sections 4.1 and 4.3, the exit velocities are:

Table 4: Mass flow rates and exit velocities.

Quantity | Value
Total mass flow, ˙mtotal | 0.2754 kg/s
Oxidizer mass flow, ˙mox | 0.2098 kg/s
Fuel mass flow, ˙mfuel | 0.0656 kg/s
Fuel (LCH4, annular) exit velocity, Vfuel | 13.66 m/s
Oxidizer (LOX, radial) exit velocity, Vox | 16.10 m/s

### 5.2 Non-Dimensional Spray Parameters

Table 5: Non-dimensional numbers and spray angle estimates.

Quantity | Value
K1 (characteristic number) | 0.849
TMR (Total Momentum Ratio) | 1.548
Spray half-angle, momentum balance | 66.9◦
Spray half-angle, empirical correlation [5] | 57.3◦
Weber number | 146.3
Reynolds number, fuel side (annular gap) | 36,720
Reynolds number, oxidizer side (radial gap) 68,324

Both Reynolds numbers place the exit flows firmly in the turbulent regime. The two independent spray half-angle estimates (momentum balance and empirical correlation) agree to within about 15%, consistent with the disagreement typically reported between these two methods in the literature and not indicative of an error.

Preliminary Analytical Design of a Spiral-Vane Pintle Injector Manifold | 7

### 5.3 Spiral Manifold Area Profile

Applying Equation 3 to the fuel-side volumetric flow rate (Qfuel = ˙mfuel/ρCH4) at the target constant velocity Vfuel gives a starting cross-sectional area A0 ≈ 12.6 mm²
, tapering to the 5%
floor Amin ≈ 0.63 mm² near θ = 360◦
. Figure 1 shows the resulting area and equivalent circular channel-radius profiles; Figure 2 shows the corresponding plan-view spiral envelope, generated for an assumed (placeholder) outer-wall radius shrinking linearly from 25 mm to 15 mm around the circumference – a packaging assumption only, not yet derived from an actual injector body envelope (see Section 6.1).

fig1_area_channel_profile.png

Figure 1: Required spiral cross-sectional area (top) and equivalent circular channel radius (bottom) as a function of angular position θ, stopping at the 5% area floor near θ = 360◦

### 5.4 Scale-Effect and Boundary-Layer Validation

Because the spiral channel operates at millimetre scale rather than the metre scale of a typical turbomachinery volute, the central question for this concept is whether the channel remains large compared to the boundary layer growing along its walls. Applying the conservative (laminar flat-plate) boundary-layer estimate of Section 3.2 across the full spiral path (local Reynolds number ranging from 293,764 at θ = 0◦ down to 65,688 at θ = 360◦ as the channel narrows) gives a minimum channel-radius-to-boundary-layer margin of 0.4298 mm, occurring at θ ≈ 343◦

Preliminary Analytical Design of a Spiral-Vane Pintle Injector Manifold | 8

fig2_spiral_planview.png

Figure 2: Plan-view outer-wall envelope of the spiral manifold, generated using a placeholder linear radius taper (25 mm → 15 mm) for path-length estimation only.

– i.e. near the narrow end of the spiral, as expected. Figure 3 plots the channel radius, boundary-layer thickness, and margin around the full circumference.

Since the minimum margin remains positive across the full spiral, the design passes the scale-effect gate defined for this first-pass analysis: the boundary layer does not fill the channel at any angular station, so the inviscid, constant-velocity taper assumption underlying the area profile is not immediately invalidated. This result is flagged in the sizing script as “margin looks reasonable for a first-pass design; proceed to CFD verification before committing” – i.e. a go/no-go filter, not a substitute for three-dimensional viscous analysis.

### 5.5 Pressure Drop Budget

Table 6 and Figure 4 summarize the estimated manifold pressure drop against the 20%-of-Pc budget (4.0 bar).

Table 6: Manifold pressure drop estimate vs. budget.

Component | Pressure drop
Spiral friction (Darcy–Weisbach, Blasius) | 0.2984 bar
Turning vanes (Kvane = 0.3, placeholder) | 0.1069 bar
Total manifold pressure drop | 0.4053 bar
Budget (20% of Pc = 20 bar) | 4.0000 bar

The total estimated manifold pressure drop is roughly one-tenth of the available budget, indicating that pressure drop is not a limiting constraint on this design – the scale-effect (boundary-layer) check of Section 5.4 is the more restrictive of the two go/no-go gates evaluated in this analysis.

Preliminary Analytical Design of a Spiral-Vane Pintle Injector Manifold | 9

fig3_scale_effect_check.png

Figure 3: Scale-effect check: channel radius, (conservatively estimated, laminar-flat-plate) boundary-layer thickness, and resulting margin, as a function of angular position.

### 5.6 Vane-Count Sensitivity

Because the vane loss coefficient used above (Kvane = 0.3) is itself a placeholder pending a finalized vane geometry, a sensitivity sweep was run using a crude linear loss-vs-count model (K ≈ 0.02×nvanes) to check that a reasonable range of vane counts would not, on its own, push the total pressure drop out of budget.

Across the full swept range (6 to 24 vanes), the total pressure drop remains well under half of the available budget, suggesting the final vane count can be selected primarily on swirl-removal effectiveness rather than being constrained by pressure drop.

## 6 Discussion

### 6.1 Assumptions and Limitations

This analysis is a first-pass, one-dimensional sizing exercise, and several of its inputs are explicitly acknowledged placeholders rather than finalized values. These are listed here so that the results of Section 5 are read with the correct degree of confidence:

Preliminary Analytical Design of a Spiral-Vane Pintle Injector Manifold | 10

fig4_pressure_drop_breakdown.png

Figure 4: Manifold pressure-drop breakdown (friction and vane minor loss) against the pressure-drop budget.

| Linear bleed-off and constant-velocity target. The area profile of Equation 3 assumes flow bleeds off the spiral uniformly per unit angle, and targets constant velocity rather than constant static pressure around the circumference. Both are simplifying, physically reasonable starting choices, not results proven optimal by this analysis; the vane-count sweep of Section 5.6 is a starting point for further sensitivity study, not a final optimization.
| Vane loss coefficients are placeholders. Kvane = 0.3 (Section 5.5) and the linear K-vs- count model (Section 5.6) are representative values, not measured or CFD-derived figures, and should be replaced once vane geometry is finalized.
| The Weber number formula is carried over from a liquid–gas correlation. As noted in Section 3.4, this design’s fuel is liquid (not gaseous, as in the correlation’s original derivation), so the computed Weber number (W e = 146.3) should be treated as a qualitative atomization sanity check only, not a validated liquid–liquid breakup prediction.
| The boundary-layer estimate is conservative, not exact. The laminar flat-plate for- mula used in Section 5.4 is known to overestimate boundary-layer thickness at the design’s actual (turbulent) Reynolds numbers; this makes the computed margin (0.43 mm) an un- derestimate of the true margin, i.e. the conservative, safe-direction error – but it is not a substitute for a turbulent boundary-layer correlation or CFD.
| The spiral envelope radii (25 mm → 15 mm) are unjustified placeholders. They were chosen only to compute a path length for the Section 5.5 friction estimate and are not derived from mass flow, channel size, or any actual packaging constraint. They must be replaced with values set by the real injector body outer diameter and manufacturing envelope before the pressure-drop result of Section 5.5 can be fully trusted.

Preliminary Analytical Design of a Spiral-Vane Pintle Injector Manifold | 11

Table 7: Vane-count sensitivity (crude placeholder loss model).

Number of vanes | Total manifold ∆P
6 | 0.3411 bar
8 | 0.3554 bar
12 | 0.3839 bar
16 | 0.4124 bar
24 | 0.4694 bar
| The baseline geometry (Table 2) was validated at a different design point. Erkal’s Type-1 geometry [5] was derived for a LOX/GCH4 (gaseous fuel) mission; adopting it di- rectly for a LOX/LCH4 (liquid fuel) design point is why Sections 5.1–5.2 exist – to confirm the geometry still produces physically sane velocities and non-dimensional numbers under the new propellant pair, which it does, but it remains a borrowed starting point rather than a geometry re-derived for this specific mission.
| This analysis does not replace CFD or cold-flow testing. Every number in Section 5 should be treated as a go/no-go filter for progressing to the next project phase, not as a final design value.

### 6.2 Relation to the Literature

The propellant pair and general pintle geometry used here follow directly from Vasques and Haidn [6] and Erkal [5] respectively, and the spray-quality checks (TMR, K1, empirical sprayangle correlation) follow the methodology established by Son et al. [4] and used by Erkal [5]. The manifold-uniformity problem itself, however, is not directly addressed by any of the pintle-specific literature reviewed in Section 2; the spiral+vane concept investigated here is instead an adaptation of a manifold geometry conventionally used in turbomachinery casings, applied at a considerably smaller (millimetre) scale than its usual (metre-scale) application. The scale-effect check of Section 5.4 is, in effect, the analytical test of whether that cross-domain adaptation remains physically valid at this scale – and the result of this preliminary analysis is that it does, subject to the limitations listed above.

## 7 Conclusion and Future Work

This report has documented the preliminary, analytical (pre-CAD) design phase of a spiral-vane manifold for a throttling LOX/LCH4 pintle injector. Starting from a NASA CEA thermodynamic design point (O/F = 3.2, Pc = 20 bar, 750 N thrust) and a baseline pintle/sleeve geometry adopted from the literature, a MATLAB sizing script was used to derive the spiral manifold’s area profile from mass conservation, evaluate spray-quality non-dimensional numbers, and check two go/no-go gates: a scale-effect (boundary-layer) validity check and a pressure-drop budget check. Both gates were passed: the minimum channel-to-boundary-layer margin (0.43 mm) remains positive across the full spiral, and the estimated total manifold pressure drop (0.41 bar) remains well within the 4.0 bar budget.

These results support proceeding to the next phase of the project, which lies outside the scope of this report: parametric CAD modelling of both the spiral+vane manifold and a matched baseline (single-side-inlet) manifold in SolidWorks, CFD verification of the scale-effect and uniformity assumptions made here, and – pending manufacturing feasibility – cold-flow testing to experimentally compare circumferential uniformity between the two manifold configurations.

Preliminary Analytical Design of a Spiral-Vane Pintle Injector Manifold | 12

fig5_vane_sensitivity.png

Figure 5: Total manifold pressure drop vs. number of turning vanes (crude placeholder loss model), against the 4.0 bar budget.

Several of the placeholder inputs identified in Section 6.1 (vane loss coefficient, spiral envelope radii, bleed-off profile) should be revisited and refined using CFD results before being carried into a manufacturable design.

## References

[1] G. W. Elverum, TRW Inc., “Combustion Apparatus Having a Coaxial-Pintle Reactant Injector,” U.S. Patent Application, filed 1 November 1971 (issued as U.S. Patent 4,206,594).
[2] G. A. Dressler and J. M. Bauer, “TRW Pintle Engine Heritage and Performance Characteristics,” AIAA 2000-3871, 36th AIAA/ASME/SAE/ASEE Joint Propulsion Conference, 2000.
[3] R. Nardi Rezende, A. Pimenta, and V. de Castro Perez, “Experiments with the Pintle Injector.”
[4] M. Son, K. Radhakrishnan, J. Koo, O. C. Kwon, and H. D. Kim, “Design Procedure of a Movable Pintle Injector for Liquid Rocket Engines,” Journal of Propulsion and Power, Vol. 33, No. 4, 2017. DOI: 10.2514/1.B36301.
[5] B. Erkal, “Design of a Pintle Injector,” M.S. Thesis, Middle East Technical University, September 2019.

Preliminary Analytical Design of a Spiral-Vane Pintle Injector Manifold | 13
[6] B. B. Vasques and O. J. Haidn, “Effect of Pintle Injector Element Geometry on Combustion in a Liquid Oxygen/Liquid Methane Rocket Engine,” 7th European Conference for Aeronautics and Aerospace Sciences (EUCASS), 2017. DOI: 10.13009/EUCASS2017-88.
[7] J. Cha, E. Andersson, and A. Bohlin, “A Numerical Approach to Optimize the Design of a Pintle Injector for LOX/GCH4 Liquid-Propellant Rocket Engine,” Aerospace, Vol. 10, Article 582, 2023.
[8] R. Rajendran, S. Prasad, S. Subhashree, T. S. Phutane, and V. S. Saoor, “Design and Optimization of Pintle Injector for Liquid Rocket Engine,” International Journal of Engineering Applied Sciences and Technology (IJEAST), Vol. 5, Issue 1, pp. 151–159, 2020.
[9] K. K. Sanjit, A. G. Raj, A. B. Ashok, Manohar N, P. R. V, H. G. M, and D. S. Reddy, “Theoretical Modeling and Design of a Coaxial-Swirl Injector and Thruster Components for MMH/NTO-Based Upper Stage Thrusters,” Acceleron Aerospace Journal (AAJ), Vol. 5, Issue 1, Article AAJ.11.2106-2541.
[10] B. J. McBride and S. Gordon, Computer Program for Calculation of Complex Chemical Equilibrium Compositions and Applications, I. Analysis, NASA Reference Publication 1311, 1994.
[11] S. Gordon and B. J. McBride, Computer Program for Calculation of Complex Chemical Equilibrium Compositions and Applications, II. Users Manual and Program Description, NASA Reference Publication 1311, 1996.
[12] National Institute of Standards and Technology, NIST Chemistry WebBook, Fluid Data for Oxygen (O2) and Methane (CH4), https://webbook.nist.gov.
[13] G. P. Sutton and O. Biblarz, Rocket Propulsion Elements, John Wiley & Sons.

Preliminary Analytical Design of a Spiral-Vane Pintle Injector Manifold | 14

## A Master Parameter Summary

Table 8 summarizes every parameter pinned down during this preliminary analytical phase of the project. Parameters belonging to later project phases (throttling mechanism, turning-vane final geometry, structural sizing, manufacturing, and test instrumentation) have not yet been determined and are marked accordingly.

Table 8: Master parameter summary – analytical design phase.

Category | Parameter | Value

Mission & requirements

Target thrust | 750 N
Chamber pressure | 20 bar
Throttle ratio (target) | 3:1 (not yet analysed)
Propellant pair | LOX / LCH4
O/F ratio | 3.2

Propellant flow

Total mass flow rate | 0.2754 kg/s
Oxidizer mass flow rate | 0.2098 kg/s
Fuel mass flow rate | 0.0656 kg/s
Fuel exit velocity | 13.66 m/s
Oxidizer exit velocity | 16.10 m/s

Pintle/sleeve geometry

Pintle tip diameter, Dt | 8 mm
Pintle rod diameter, Dp | 3 mm
Pintle angle, α | 20◦
Annular gap, tag | 0.5 mm
Pintle gap thickness, tpg | 1.5 mm
Opening distance at max thrust, Ltod | 0.5 mm

Spiral manifold

| Starting area, A0 | 12.6 mm²
| Minimum area (5% floor), Amin | 0.63 mm²
| Starting / ending envelope radius | 25 mm / 15 mm (placeholder)
| Min. boundary-layer margin | 0.43 mm at θ = 343◦
Throttling mecha- nism | Actuator, bushings, seals | Not yet determined – future
| | phase
Turning vanes | Final count, angle, thickness | Not yet determined – future
| | phase
Structural/material Wall thickness, material, safety
| factor | Not yet determined – future
| | phase
Manufacturing | Method, tolerances | Not yet determined – future
| | phase
Test & instrumen- tation | Flow meters, pressure taps, cam-
| eras | Not yet determined – future
| | phase
