prathiitsharma-cmd/Pintle-Injector-Re-Design/references/bibliography.md

---
title: References
---

# References

Full-text PDFs of the sources below are **not** committed to this repository — several are copyrighted journal articles, a thesis, and a commercial textbook. They're kept locally on the project owner's machine for personal reference. This file exists so the repo still documents what informed the design without redistributing anyone else's copyrighted work.

## Textbooks

- Sutton, G. P., & Biblarz, O. (2017). *Rocket Propulsion Elements* (9th ed.). John Wiley & Sons.
- NASA reference document (scanned copy, title not machine-readable from the PDF — update this entry with the correct title/report number when convenient).

## Journal articles & conference papers

- Dressler, G. A., & Bauer, J. M. (2000). *TRW Pintle Engine Heritage and Performance Characteristics*. AIAA 2000-3871.
- Son, M., Radhakrishnan, K., Koo, J., Kwon, O. C., & Kim, H. D. (2017). *Design Procedure of a Movable Pintle Injector for Liquid Rocket Engines*. Journal of Propulsion and Power, 33(4). https://doi.org/10.2514/1.B36301
- Vasques, B. B., & Haidn, O. J. (2017). *Effect of Pintle Injector Element Geometry on Combustion in a Liquid Oxygen/Liquid Methane Rocket Engine*. 7th European Conference for Aeronautics and Aerospace Sciences (EUCASS). https://doi.org/10.13009/EUCASS2017-88
- Cha, J., Andersson, E., & Bohlin, A. (2023). *A Numerical Approach to Optimize the Design of a Pintle Injector for LOX/GCH4 Liquid-Propellant Rocket Engine*. Aerospace, 10(7), 582.
- Rajendran, R., Prasad, S., S, S., Phutane, T. S., & Saoor, V. S. (2020). *Design and Optimization of Pintle Injector for Liquid Rocket Engine*. International Journal of Engineering Applied Sciences and Technology, 5(1), 151–159.
- Sanjit, K. K., Raj, A. G., Ashok, A. B., N, M., Raj V, P., G M, H., & Reddy, D. S. (2024). *Theoretical Modeling and Design of a Coaxial-Swirl Injector and Thruster Components for MMH/NTO-Based Upper Stage Thrusters*. Acceleron Aerospace Journal, 5(1), 1274–1280. https://doi.org/10.61359/11.2106-2541
- Rezende, R. N., Pimenta, A., & de Castro Perez, V. *Experiments with the Pintle Injector*.

## Theses & student project reports

- Erkal, B. *Design of a Pintle Injector* (Master's thesis). Middle East Technical University.
- Narayanan, S. P., Arun, S., & Arul, S. *Experimental Analysis on Pintle Fuel Injector for Rocket Engine* (undergraduate project report). Not affiliated with this project's authors.

---

*Have the actual PDFs and want them on hand? They're kept in `Design Guide/`, `ResearchProject Papers/`, `Rocket Propulsion Elements.pdf`, and `Final Year Project.pdf` locally — those paths are git-ignored, not deleted.*
