prathiitsharma-cmd/Pintle-Injector-Re-Design/docs/report/figures/fig1-area-channel-profile.png

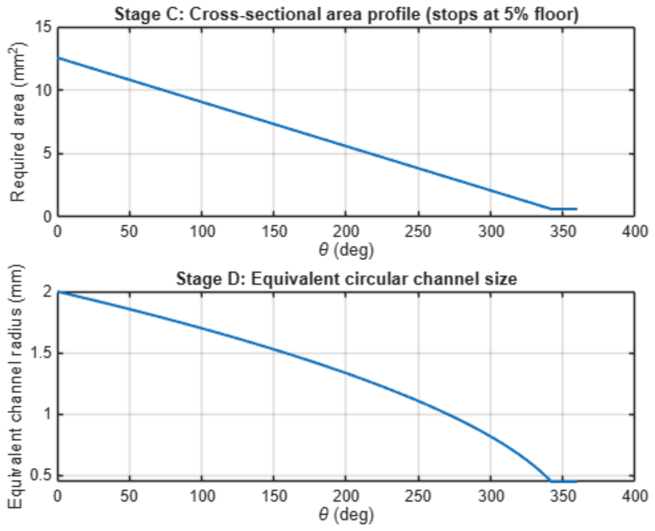
docs/report/figures/fig1-area-channel-profile.png
