prathiitsharma-cmd/Pintle-Injector-Re-Design/docs/report/figures/fig2-spiral-planview.png

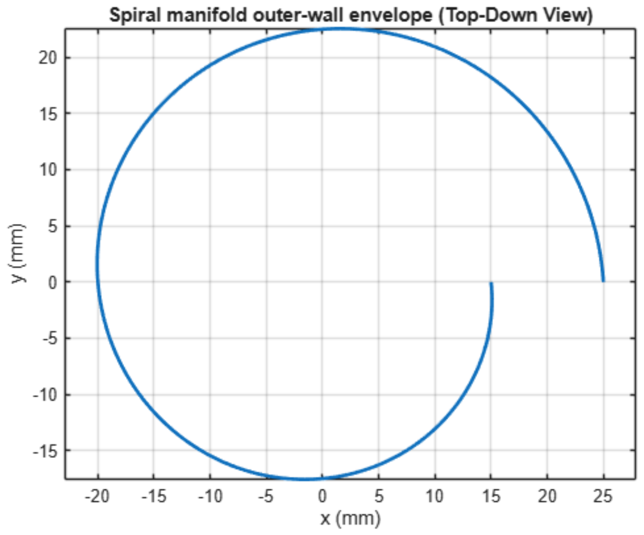
docs/report/figures/fig2-spiral-planview.png
