prathiitsharma-cmd/Pintle-Injector-Re-Design/docs/report/figures/fig3-scale-effect-check.png

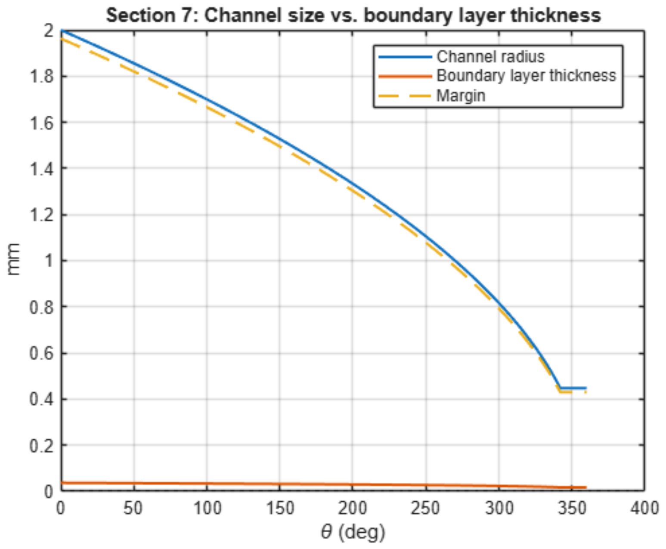
docs/report/figures/fig3-scale-effect-check.png
