prathiitsharma-cmd/Pintle-Injector-Re-Design/docs/report/figures/fig4-pressure-drop-breakdown.png

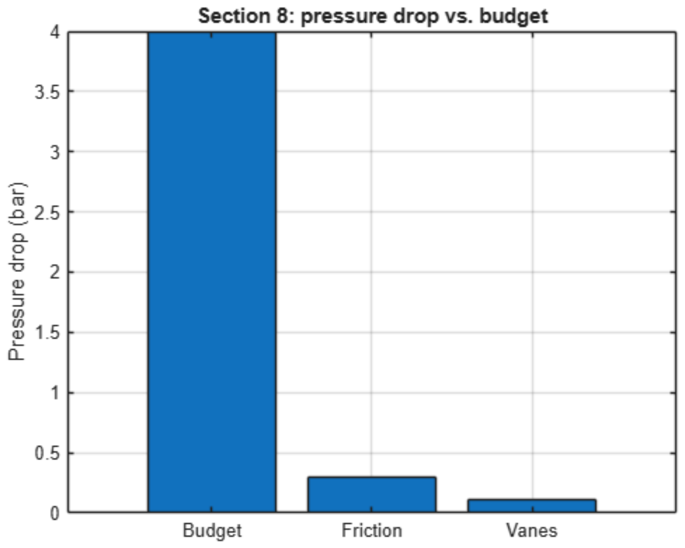
docs/report/figures/fig4-pressure-drop-breakdown.png
