prathiitsharma-cmd/Pintle-Injector-Re-Design/docs/report/figures/fig5-vane-sensitivity.png

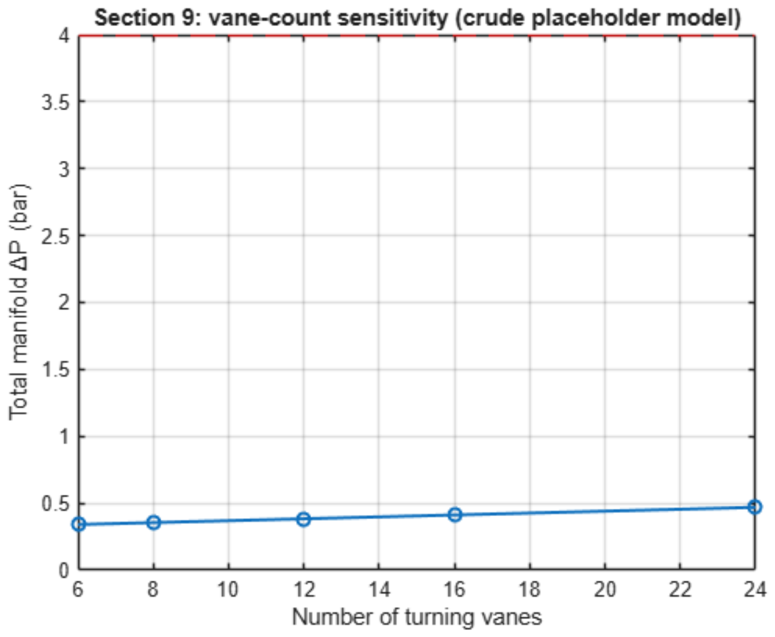
docs/report/figures/fig5-vane-sensitivity.png
