prathiitsharma-cmd/Pintle-Injector-Re-Design/cad/exports/pintle-assembly.step

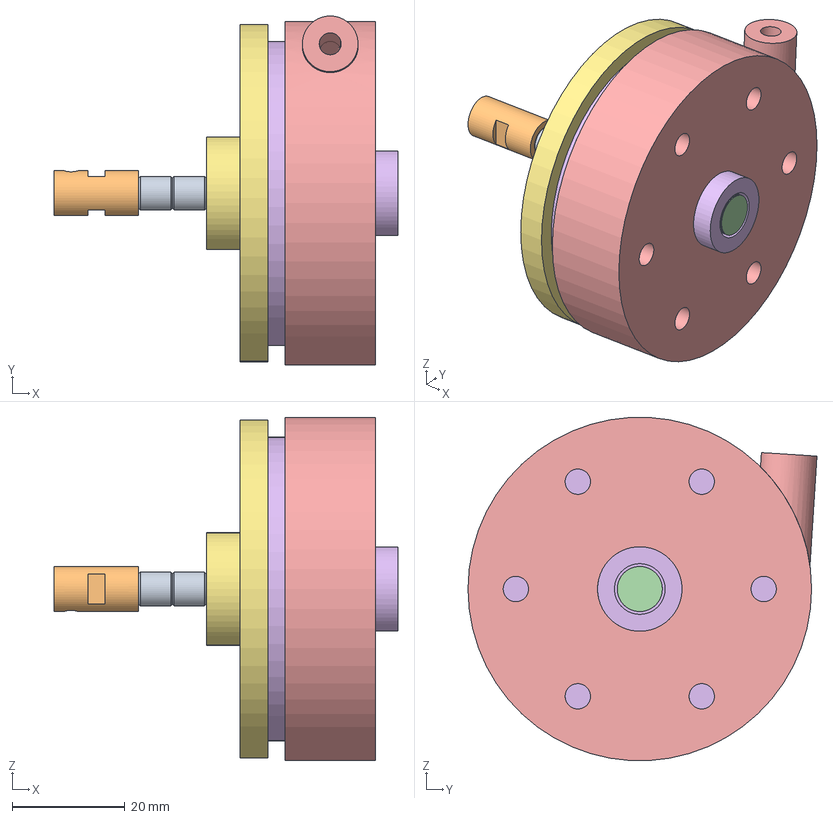
[picture p11: CAD file, 2026-08-26]
cad/exports/pintle-assembly.step
61.0 x 62.0 x 60.9 mm
