prathiitsharma-cmd/Pintle-Injector-Re-Design/cad/exports/guide-bushing.step

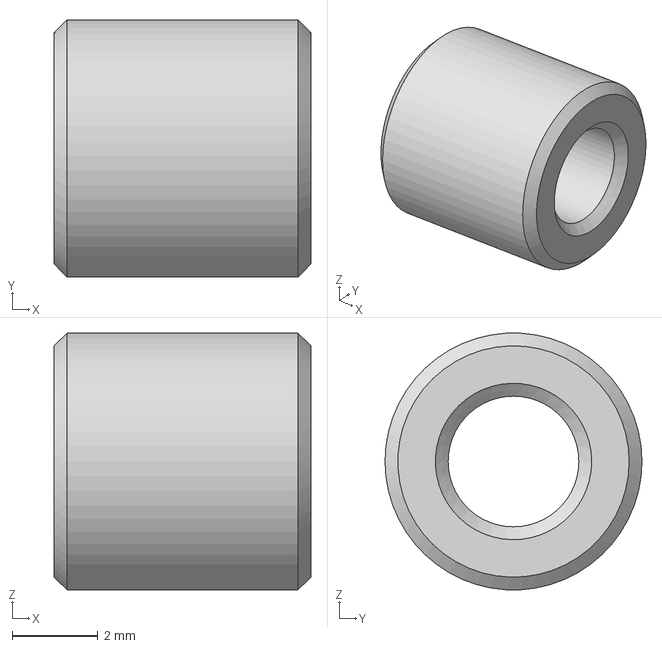
[picture p12: CAD file, 2026-08-26]
cad/exports/guide-bushing.step
6.00 x 6.00 x 5.99 mm
