prathiitsharma-cmd/Pintle-Injector-Re-Design/cad/exports/pintle-rod-and-tip.step

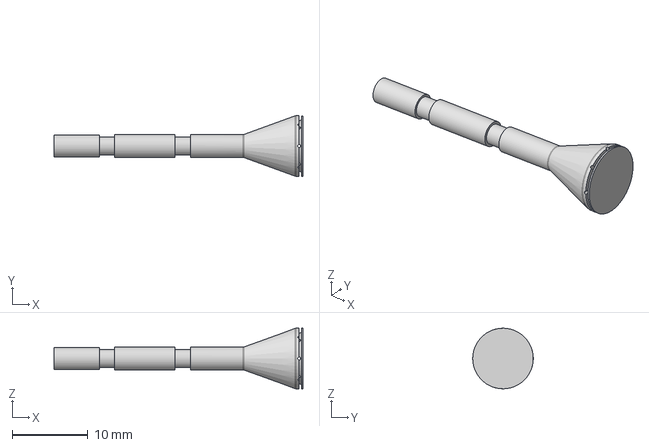
[picture p13: CAD file, 2026-08-26]
cad/exports/pintle-rod-and-tip.step
32.9 x 8.00 x 8.00 mm
