prathiitsharma-cmd/Pintle-Injector-Re-Design/cad/exports/actuator-coupling.step

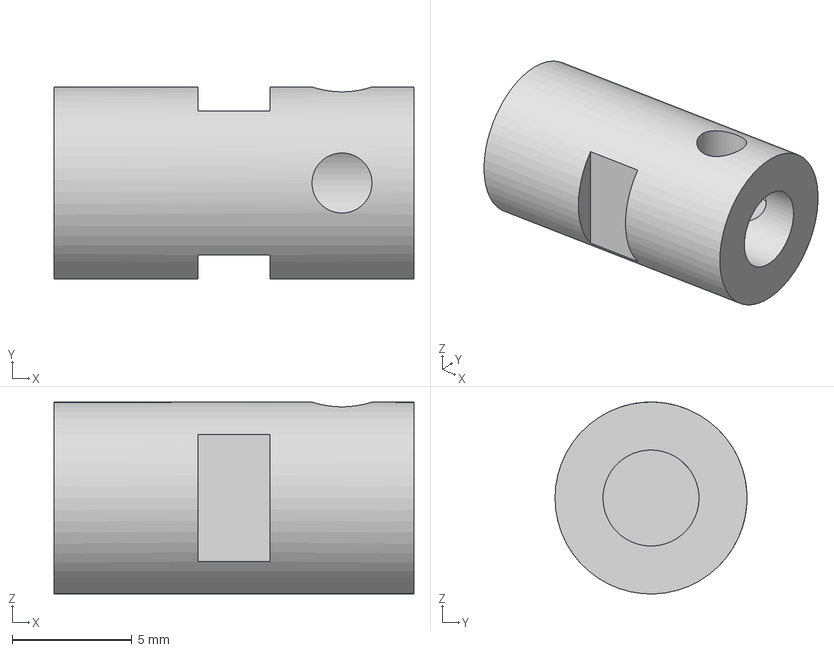
[picture p14: CAD file, 2026-08-26]
cad/exports/actuator-coupling.step
15.0 x 8.00 x 8.00 mm
