prathiitsharma-cmd/Pintle-Injector-Re-Design/cad/exports/turning-vane.step

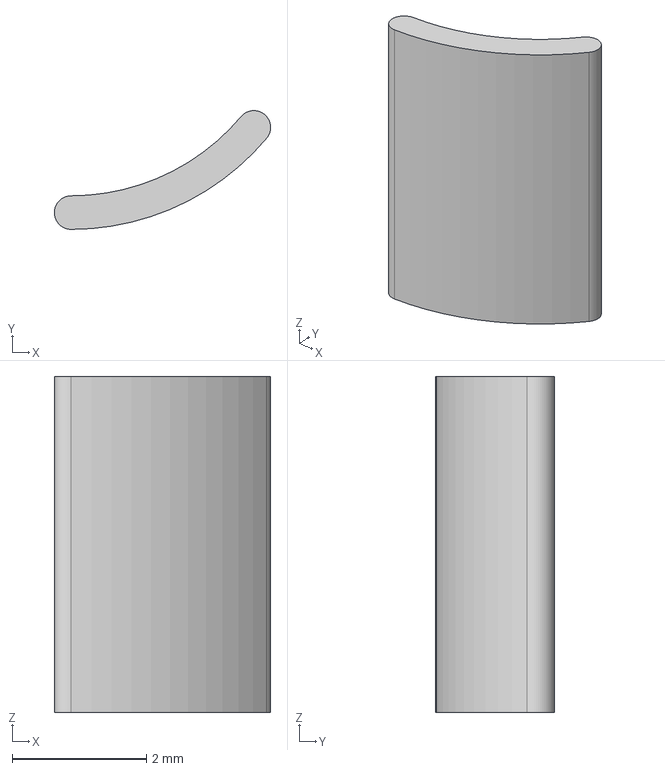
[picture p15: CAD file, 2026-08-26]
cad/exports/turning-vane.step
3.22 x 1.77 x 5.00 mm
