prathiitsharma-cmd/Pintle-Injector-Re-Design/cad/exports/faceplate.step

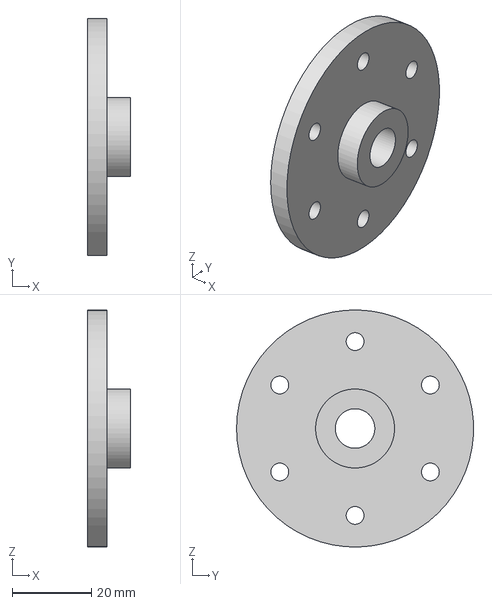
[picture p16: CAD file, 2026-08-26]
cad/exports/faceplate.step
11.0 x 60.0 x 60.0 mm
