prathiitsharma-cmd/Pintle-Injector-Re-Design/cad/exports/pintle-sleeve-tip-ring.step

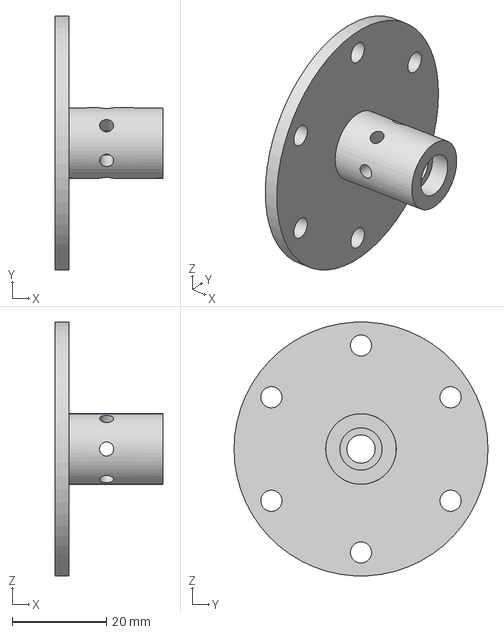
[picture p17: CAD file, 2026-08-26]
cad/exports/pintle-sleeve-tip-ring.step
23.0 x 54.0 x 53.9 mm
