prathiitsharma-cmd/Pintle-Injector-Re-Design/cad/exports/baseline-single-inlet-manifold.step

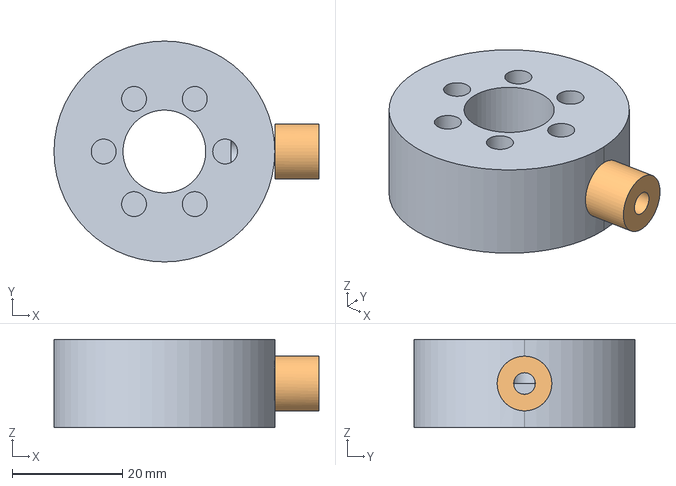
[picture p18: CAD file, 2026-08-26]
cad/exports/baseline-single-inlet-manifold.step
48.0 x 40.0 x 16.0 mm
