prathiitsharma-cmd/Pintle-Injector-Re-Design/cad/exports/vane-manifold.step

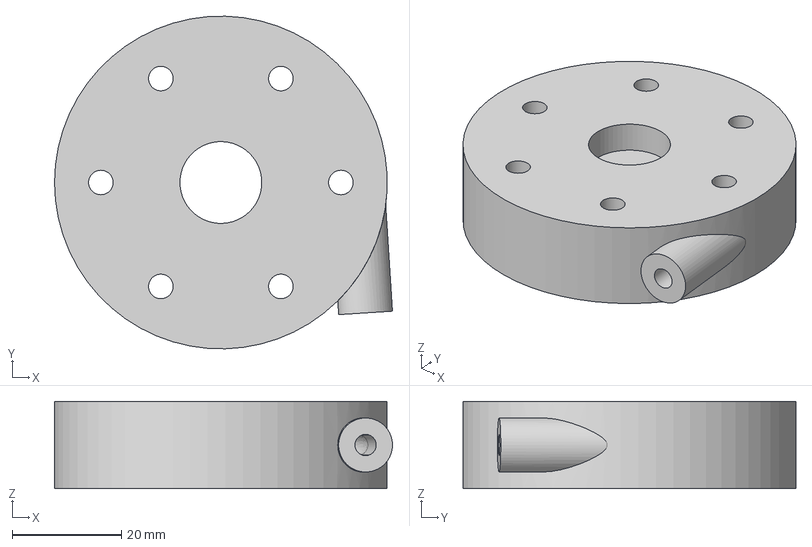
[picture p19: CAD file, 2026-08-26]
cad/exports/vane-manifold.step
62.0 x 61.0 x 16.0 mm
