prathiitsharma-cmd/Pintle-Injector-Re-Design/docs/design-guide/pintle-injector-solidworks-guide.docx

SOLIDWORKS MODELING GUIDE

Movable Pintle Injector with Spiral + Vane Manifold

Part-by-part construction using advanced SolidWorks features,

paired with the separate 2D Reference Drawing Pack (8 sheets)

Design point | LOX/LCH4, O/F = 3.2, Pc = 20 bar, Thrust = 750 N, Ae/At = 5
Baseline geometry | METU Type-1 (Erkal, 2019, Thesis Table 3.1): α=20°, tag=0.5mm, Dt=8mm, tpg=1.5mm, Dp=3mm
Novel element | Spiral (volute) fuel manifold with turning vanes vs. conventional single side-inlet
Scope | Cold-flow demonstrator / CFD comparison — no hot-fire manufacturing implied by this guide
Companion file | pintle_injector_2D_reference_drawings.pdf — 8 dimensioned sheets, one per part

# 0. How To Use This Guide

This guide walks through building every part of the movable pintle injector assembly in SolidWorks, using the parametric / advanced-feature workflow already scoped in the project notes (equation-driven dimensions, lofts, helix/spiral sweeps, patterns, configurations). It assumes SolidWorks 2021+ with the Premium package for Flow Simulation and Motion Study (both optional but referenced).

Each part section below has a matching numbered sheet in the companion PDF, “pintle_injector_2D_reference_drawings.pdf.” Those sheets are hand-built dimensioned reference sketches — NOT exported SolidWorks drawings — meant to be read side-by-side with this guide while you sketch inside SolidWorks. Cross-section views, leaders, and notes on each sheet call out every dimension you need; this guide tells you which SolidWorks feature to use to realize each one and in what order.

NOTE — This is a design/CFD-phase reference, not a certified manufacturing drawing set. Tolerances, thread callouts, seal sizes, and fastener patterns are reasonable placeholders (flagged inline) — verify them against your actual hardware, manufacturing process, and a proper stress/thermal check before cutting flight or hot-fire hardware.

## 0.1 Part Index

Part No. | Part Name | Drawing Sheet | Key Advanced Feature(s)
PI-001 | Pintle Rod & Tip | Sheet 1 | Revolve, Shell/Cut bore, Circular Pattern (alt. slotted tip), Equations
PI-002 | Pintle Sleeve / Tip Ring | Sheet 2 | Multi-step Revolve, Equation-linked bore diameters
PI-003 | Outer Body — Spiral+Vane Manifold | Sheet 3 | Helix/Spiral, Loft w/ Guide Curves, Wrap, Boolean subtract
PI-003B | Outer Body — Baseline Manifold (control) | Sheet 4 | Swept Boss/Cut (constant section)
PI-005 | Turning Vane (×12) | Sheet 5 | Boundary/Loft blade profile, Circular Component Pattern
PI-006 | Faceplate / Retaining Backplate | Sheet 6 | Revolve, Circular Pattern (bolt holes), Groove cut
PI-007 | Guide Bushing (×2) | Sheet 7 | Revolve with chamfers, Equation-linked bore
PI-008 | Actuator Coupling | Sheet 8 | Revolve, Cosmetic/Cut thread, Hole Wizard (set screws)

# 1. Global Parameter Sheet (Do This First)

Before modeling any part, set up a single equation-driven parameter sheet so every downstream sketch references a variable — never a raw number. This is what lets you change tag, Dt, or the throttle position once and have every part and every drawing update together.

## 1.1 Create the master equations file

1. Start a new Part (or use a lightweight “master” part purely for equations).
2. Tools → Equations → Global Variables. Enter each variable in the table below.
3. File → Save As → keep this part as e.g. “pintle_master_equations.SLDPRT”.
4. In every OTHER part, go to Equations → Manage → “Link to External File” and browse to this master file. All parts now share one source of truth.

## 1.2 Global variable table

Variable | Value | Meaning | Source
Dp | 3.00 mm | Pintle rod / shaft diameter | METU Table 3.1, Type-1
Dt | 8.00 mm | Pintle tip diameter | METU Table 3.1, Type-1
alpha | 20 deg | Pintle half-angle from centerline | METU Table 3.1, Type-1
tag | 0.50 mm | Annular (fuel) gap at tip, nominal/max-thrust | METU Table 3.1, Type-1
tpg | 1.50 mm | Pintle gap thickness (upstream fuel annulus) | METU Table 3.1, Type-1
tt | 1.00 mm | Tip land (flat) axial thickness | Ref. image / METU Fig. 2.1
cone_len | = (Dt-Dp)/2 / tan(alpha) | Cone axial length — DERIVED, do not hardcode | = 6.87 mm
Laod_max | 0.50 mm | Max opening distance at 750N / O-F=4 design pt | METU Table 2.3
Laod_min | 0.00 mm | Closed position | —
D_sleeve_tip | = Dt + 2*tag | Sleeve bore ID at tip zone | Derived
D_sleeve_shaft | = Dp + 2*tpg | Sleeve bore ID at shaft zone | Derived
R_spiral_start | 25.0 mm | Spiral centerline radius at θ=0° | Packaging — flag as placeholder
R_spiral_end | 15.0 mm | Spiral centerline radius at θ=360° | Packaging — flag as placeholder
A0 | 12.0 mm² | Spiral starting cross-section area | MATLAB v2 script Sec.6
A_min | 0.6 mm² | 5% floor area (avoids singularity) | MATLAB v2 script Sec.6
n_vanes | 12 | Turning vane count (baseline) | Sensitivity sweep midpoint
channel_h | 5.0 mm | Spiral channel height | Scale-effect check, δ/h < 0.3

NOTE — R_spiral_start / R_spiral_end are flagged in the project's own review log as unjustified placeholders — set them from your actual injector-body envelope and packaging constraints before finalizing PI-003, not after. Everything downstream (loft path, body OD, tongue location) depends on these two numbers.

## 1.3 Why equations before geometry

- Changing tag (throttle gap) later updates the sleeve bore, the body clearance, and the drawing sheet in one edit — no hunting through sketches.
- The spiral loft (PI-003) and the equivalent-area baseline torus (PI-003B) can both reference A0 directly, keeping the two manifolds a fair comparison by construction, not by manual re-entry.
- Configurations / Design Tables (Section 11) drive Laod through this same variable set, so throttle-position drawings stay correct automatically.

# 2. Part: Pintle Rod & Tip (PI-001)

Companion drawing: Sheet 1 of 8

## 2.1 What it does

Central hollow rod carrying LOX down the axis; the conical tip turns that flow from axial to radial at the exit, forming the oxidizer sheet that impinges with the fuel sheet coming off the sleeve/manifold.

## 2.2 Build order

1. Sketch (Front Plane, on centerline): a single line profile of the rod cross-section — shaft radius Dp/2 for the shaft length, then a line at angle ‘alpha’ out to Dt/2 (use a dimension driven by the equation, not a typed angle, so it tracks ‘alpha’), then a short flat at Dt/2 for length ‘tt’.
2. Revolve Boss/Base about the centerline → solid rod+cone+tip-land in one feature.
3. Sketch a circle of diameter 1.5 mm (tie to an equation, e.g. ‘D_bore = Dp - 2*0.75’) on the tail face.
4. Cut-Extrude ‘Up To Surface’ or a blind depth that stops 0.5 mm short of the tip-land front face — this creates the hollow LOX bore while keeping the tip solid/capped.
5. Sketch the radial LOX exit as a thin revolved-cut groove (0.3 mm wide × 0.6 mm deep) near the front edge of the tip land. Revolved Cut, 360°, using the centerline.
6. ALTERNATE (slotted tip): instead of step 5, sketch a single small hole (~Ø0.8 mm) radially through the tip land wall, then Circular Pattern it (12×, 360°, equal spacing) about the centerline axis — this is the “shadow angle / slotted tip” option mentioned in the project's parts list. Keep whichever option you choose consistent with your CFD/atomization assumptions (continuous slot = fully axisymmetric; discrete holes = periodic, cheaper to machine).
7. Cosmetic thread (or actual Cut-Thread if you want it to render correctly in section views) on the 3 mm tail shaft: M3×0.5, 6 mm engagement, for the Actuator Coupling (PI-008).
8. Cut two shallow O-ring grooves (Extruded Cut, 2.0 mm wide × 0.3 mm deep, revolved) on the shaft where it passes through the guide bushings / dynamic seal in the Faceplate.
9. Fillet the cone-to-shaft root (R0.3 min) and the cone-to-tip-land corner — sharp internal corners here are stress risers on a part that sees repeated thermal/pressure cycling.
10. Add a Sensor (right-click FeatureManager top → Sensors → Add Sensor → Dimension) on the bore wall thickness, flagged if it drops below your minimum machinable/printable wall.

NOTE — Tie every dimension used above to the global equations (Dp, Dt, alpha, tt) via the Equations manager, not by typing numbers into each sketch. This is what makes the “family of positions” assembly drawing in Section 12 possible without re-modeling.

# 3. Part: Pintle Sleeve / Tip Ring (PI-002)

Companion drawing: Sheet 2 of 8

## 3.1 What it does

Fixed ring that forms the OUTER boundary of the fuel-side flow: a small-ID bore over most of its length (the ‘tpg’ upstream annulus) that steps up to a larger-ID bore right at the tip (the ‘tag’ annular exit gap around the pintle's tip land). The pintle rod slides through it during throttling.

## 3.2 Build order

1. Sketch (Front Plane) a stepped bore profile: radius D_sleeve_tip/2 for 4.0 mm (tip zone), then a step down to D_sleeve_shaft/2 for the remaining length — both radii driven by the equations you already defined (Dt+2*tag and Dp+2*tpg), never typed as raw numbers.
2. On the same sketch, add the OD profile: constant 15.0 mm register OD along the body, stepping out to a 20.0 mm mounting flange near the upstream (fuel-inlet) end.
3. Revolve Boss/Base once with both profiles closed into a single sketch — SolidWorks handles the stepped ID/OD correctly as one revolve as long as the sketch is a single closed loop.
4. Cut an O-ring groove (1.8 mm wide × 1.2 mm deep, revolved cut) on the flange face that seats against the Outer Body manifold (PI-003 / PI-003B).
5. Add 6× clearance holes (Ø4.5) on the flange, Circular Pattern about the centerline, matching the Faceplate's bolt circle (defined in Part 6) — use the SAME equation for bolt-circle diameter in both parts so they can never drift apart.
6. ADVANCED (optional, higher fidelity): replace the stepped tip-zone bore with a bore that follows the pintle's 20° cone at a constant radial offset ‘tag’, using a Loft or a swept-cut with a tapered guide curve. This keeps the annular gap truly constant through the cone region instead of only at the flat tip-land — worth doing once the straight-bore version is validated in CFD and you want to refine.

NOTE — The straight-cylinder bore is a deliberate first-pass simplification (same spirit as the MATLAB script's thin-annulus approximation) — flag it as such in your documentation rather than presenting it as an exact match to the cone, consistent with how the project's own notes treat borrowed/simplified geometry.

# 4. Part: Outer Body — Spiral + Vane Manifold (PI-003)

Companion drawing: Sheet 3 of 8

## 4.1 What it does

The novel part of the project: a fuel manifold cavity that spirals 360° around the pintle sleeve, continuously tapering in cross-section (per mass conservation, A(θ) ∝ remaining flow) so that velocity — and therefore delivery to the annular gap — stays uniform all the way around, rather than dumping everything from one lopsided side inlet. Small turning vanes at the inner boundary kill the residual tangential (swirl) velocity right before the flow turns into the axial annular gap.

## 4.2 Why this can't be built with a simple Revolve

A spiral with a shrinking cross-section is a 3D space curve (the centerline path) with a variable-size profile swept along it — SolidWorks' native tools for this are the Helix/Spiral curve (for the path) and Loft with Guide Curves (for the shrinking cross-section), not Revolve or a simple Sweep.

## 4.3 Build order

1. Start with a solid cylindrical body blank: Revolve or Extrude a disc, OD ≈ (R_spiral_start + wall) × 2, thickness ≈ channel_h + 2×wall (≈ 16 mm). This is the stock you'll cut the spiral cavity from.
2. Insert → Curve → Helix/Spiral. On a sketch circle of radius R_spiral_start, choose ‘Spiral’ mode, set it to end at radius R_spiral_end over exactly 1 revolution (360°), constant pitch not required — this generates the 3D centerline path r(θ) directly from your two equation-driven radii.
3. Create 5–10 reference planes normal to this spiral curve at even θ intervals (Insert → Reference Geometry → Plane → ‘Normal to Curve’ at a chosen point/percentage along the curve).
4. On each plane, sketch a circle centered on the spiral curve, with diameter d(θ) = 2·√(A(θ)/π), where A(θ) = A0 − (A0−A_min)·(θ/360°). Drive each circle's diameter by an equation referencing its own θ value — don't eyeball the taper.
5. Loft Boss/Base through all the profile circles, using the spiral curve itself as a Guide Curve so the loft follows the path exactly rather than interpolating a straight line between profiles.
6. Boolean-subtract: Combine (Subtract) the lofted spiral solid from the cylindrical body blank, leaving the spiral cavity as a void inside the body.
7. Model the tongue wall: a thin (0.5–1.0 mm) solid wall separating the finished spiral (inner, r=R_spiral_end) from the fresh incoming flow (outer, r=R_spiral_start) where the two ends meet after the full wrap. Sketch and Extruded Boss it directly, or leave uncut material between the loft's start and end profiles if your loft naturally leaves a gap there.
8. Cut the central sleeve bore (Ø15.0, matching PI-002's OD) straight through the body on the main axis — simple Extruded Cut.
9. Model the tangential inlet port: a cylindrical boss (Extruded Boss, Ø3.9 mm bore matching d0) tangent to the spiral's starting circle at θ=0°, sized/threaded to your chosen supply fitting.
10. Model ONE turning vane as a cut or separate body at the spiral's inner boundary (see Part 5, PI-005) — then either import it as a library feature and Circular Pattern it (12×, 30° spacing) directly in this part, or keep vanes as a separate assembled part and pattern them at the assembly level.
11. Add the 6× bolt-clearance holes on the manifold face, matching the Faceplate/Sleeve bolt circle (same shared equation as Part 3).

## 4.4 Verifying the loft did what the math says

- Use Tools → Section Properties or a simple Section View at several θ cuts and compare the measured cross-section area against A(θ) from your equation — spot-check at least 0°, 90°, 180°, 270°, 355°.
- Check the loft didn't self-intersect near θ=360° where the channel gets very small (d_min ≈ 0.87 mm) — this is exactly the singularity the 5% area floor exists to prevent; if SolidWorks complains, increase A_min slightly.
- Run Flow Simulation (Section 13) before committing to manufacture — the loft's mass-conservation shape is a first-pass model, not a guarantee of the real 3D flow behavior.

NOTE — This part carries the two flagged “open items” from the project's own limitations log: R_spiral_start/R_spiral_end are packaging placeholders, and the vane loss coefficient (used to size pressure drop, not geometry) is a placeholder too. Neither blocks building the CAD, but both should be revisited before treating this part's numbers as final.

# 5. Part: Outer Body — Baseline Single-Inlet Manifold (PI-003B)

Companion drawing: Sheet 4 of 8

## 5.1 What it does

The control case for the comparative study: a plain constant-cross-section torus cavity fed by a single radial inlet, no taper, no vanes. Everything else — pintle, sleeve, throttle stroke, bolt pattern, flow conditions — is held identical to PI-003 so any uniformity difference measured is attributable to the manifold shape, not a confound.

## 5.2 Build order

1. Sketch a circle of diameter d0 (≈ 3.9 mm, matching the spiral's STARTING area A0 for a fair comparison) on a plane offset from the centerline at radius torus_r ≈ 16 mm.
2. Sketch the circular path (a simple circle, radius torus_r, in the plan-view plane).
3. Swept Boss/Base: sweep the small circle along the circular path, 360° — this is a plain Sweep, not a Loft, since the cross-section doesn't change.
4. Subtract this torus from a cylindrical body blank (OD ≈ 40 mm, smaller than PI-003 since no spiral radius is needed).
5. Add a single radial inlet port (perpendicular to the torus, NOT tangential — this is deliberately the swirl-inducing feed geometry the spiral design is meant to fix).
6. Cut the same Ø15.0 central sleeve bore and the same 6× bolt pattern as PI-003, so PI-003 and PI-003B are physically interchangeable on the same faceplate/sleeve/pintle.

NOTE — Before trusting any comparison against PI-003, run Flow Simulation on this baseline FIRST and confirm it shows strong swirl, asymmetric pressure, and higher mass flux near the inlet side. If it doesn't, the mesh or setup is wrong — fix that before drawing conclusions from the spiral+vane run.

# 6. Part: Turning Vane, ×12 (PI-005)

Companion drawing: Sheet 5 of 8

## 6.1 What it does

Small cambered blades positioned at the spiral's inner boundary (r ≈ R_spiral_end) that turn the locally-swirling flow (≈50° from radial) down toward the axial direction before it reaches the annular exit gap — the direct analog of stay vanes in a Francis turbine spiral casing.

## 6.2 Build order

1. New part. Sketch the camber line as a single spline or circular arc, turning through the local inlet swirl angle (≈50°, tune per your own CFD/hand-calc) down to ≈0° over the chord length (3.0 mm).
2. Thicken the camber line into a blade profile: Sketch → Offset Entities (or two offset splines) at ±thickness/2 (0.25 mm each side) to get a uniform-thickness blade cross-section, rounded leading/trailing edges.
3. Boss-Extrude the 2D blade profile straight up by ‘channel_h’ (5.0 mm) — the vane spans the full channel height at the spiral's inner wall.
4. Save as its own part file so it can be inserted as a component and patterned in the assembly, OR treat it as a Library Feature / multibody cut tool if you prefer to model it directly inside PI-003.

## 6.3 Patterning 12 vanes

- Assembly-level: Insert Component (PI-005) once, mate it into position at the spiral exit, then Insert → Component Pattern → Circular Pattern, 12×, 30° spacing, about the main assembly axis.
- Part-level (inside PI-003): insert the vane geometry as a cut/boss feature, then use a standard Feature → Circular Pattern (12×) referencing the centerline axis — simpler if the whole body is one machined/printed piece anyway.

NOTE — Vane count (12) is a starting point pulled from the middle of the sensitivity sweep [6, 8, 12, 16, 24] in the MATLAB feasibility script — not yet validated by CFD or test. Chord Reynolds number at the design point is only ≈12,000, borderline for clean turning (turbines prefer >50,000), so expect the real swirl removal to be imperfect and treat the vane geometry as tunable, not fixed.

# 7. Part: Faceplate / Retaining Backplate (PI-006)

Companion drawing: Sheet 6 of 8

## 7.1 What it does

Closes the assembly on the actuator side, carries the outboard guide bushing and dynamic seal interface, and provides the actuator mounting boss. Bolts to whichever manifold body (PI-003 or PI-003B) is installed.

## 7.2 Build order

1. Sketch a disc profile (Ø60.0 OD × 5.0 thick) with a central bore (Ø10.0) on the Front Plane.
2. Revolve Boss/Base about the centerline.
3. Add the actuator mounting boss (Ø20.0 OD, 6.0 mm long, bored to your actuator's mount spec) as a second Revolve Boss or Extruded Boss on the outboard face.
4. Cut the O-ring groove (1.8×1.2 mm, revolved cut) on the sealing face against the manifold body — use the SAME groove dimensions/equations as the Sleeve flange (PI-002) if both seal against the same body face, for consistency.
5. Circular Pattern (6×) the Ø4.5 clearance bolt holes about the centerline, on the same bolt-circle-diameter equation used in PI-002/PI-003/PI-003B.
6. Add a Sensor on the center-bore-to-rod clearance once assembled (see Section 13) to catch interference automatically as Laod changes.

# 8. Part: Guide Bushing, ×2 (PI-007)

Companion drawing: Sheet 7 of 8

## 8.1 What it does

Two axial support points (per the project's own parts list — a single support point risks rod bending, as the METU thesis's own “Alternative Design 1” found the hard way) that center the pintle rod inside the body while it translates during throttling.

## 8.2 Build order

1. Sketch a simple stepped profile: Ø6.0 OD, Ø3.05 bore (Dp + 0.05 mm running clearance, driven by an equation so it tracks Dp), 6.0 mm long, with 0.3×45° chamfers on all four OD/ID edges.
2. Revolve Boss/Base once.
3. Duplicate as a second instance at assembly level (no part-level changes needed — both bushings are identical); place one near the tip-side support and one nearer the actuator end.

# 9. Part: Actuator Coupling (PI-008)

Companion drawing: Sheet 8 of 8

## 9.1 What it does

Rigid coupler transmitting the linear actuator's axial travel to the pintle rod's tail, without transmitting radial load into the rod (per the parts list requirement).

## 9.2 Build order

1. Revolve Boss/Base a plain Ø8.0 rod, 15.0 mm long, with a mid-body wrench-flat band (schematic on the drawing — model as a small flat-cut or hex if you want it functional).
2. Cut-Extrude the rod-side internal bore (Ø2.5 tap drill) 6.0 mm deep from one end, then apply a Cosmetic or Cut Thread, M3×0.5, matching the pintle rod's tail thread (PI-001).
3. Cut-Extrude the actuator-side bore (Ø4.0 clearance) 6.0 mm deep from the other end — placeholder sizing; replace with your actual actuator's output-shaft spec once selected.
4. Hole Wizard → tapped hole, M3, radial, 2× at 90° apart, through the actuator-bore wall, for set screws.

NOTE — If actuator/rod misalignment is a real concern for your rig, swap this rigid coupling for a commercial flexible/bellows coupling of matching OD rather than relying on this simple design to absorb misalignment.

# 10. Assembly Workflow

## 10.1 Bring parts together

1. New Assembly. Insert PI-002 (Sleeve) first as a fixed/grounded component.
2. Insert PI-001 (Pintle Rod). Mate: Concentric (rod axis to sleeve bore axis).
3. Mate: Distance, rod tip face to sleeve tip-zone reference plane, driven by ‘Laod’ — this is the single mate that represents the throttle position.
4. Advanced Mates → Distance (Limit): set min = Laod_min (0), max = Laod_max (0.5 mm) so you can drag the pintle within its real travel range and watch for interference live.
5. Insert PI-003 (or PI-003B). Mate: Concentric to the sleeve/rod axis, plus a coincident mate on the bolt-circle reference to fix rotation.
6. Insert PI-006 (Faceplate). Mate: Concentric + coincident face-to-face against the manifold body, matching the shared bolt-circle equation.
7. Insert PI-007 (Guide Bushings) ×2. Mate: Concentric to rod, coincident to their respective bore locations in the body/faceplate.
8. Insert PI-008 (Actuator Coupling). Mate: Concentric + coincident to the rod's tail face.
9. Insert PI-005 (Turning Vane) once, mate into position at the spiral exit, then Insert → Component Pattern → Circular Pattern (12×, 30°) about the main axis — skip this step if vanes were modeled as a feature directly inside PI-003.

## 10.2 Represent throttle states

Two ways to capture multiple throttle positions, pick based on what you need downstream:

- Configurations: right-click the Distance-Limit mate's driving dimension → ‘New Configuration.’ Create ‘Closed’ (Laod=0), ‘Mid-throttle’ (Laod≈0.25), ‘Full-open’ (Laod=0.5). Fast, good for a family-of-positions drawing (Section 12).
- Design Table (Excel-embedded): Insert → Tables → Design Table — gives you a full sweep of Laod values (e.g. matching every O/F point in the thesis's Table 2.3: 0.04, 0.15, 0.32, 0.50 mm) in one editable spreadsheet, useful if you're also driving Flow Simulation parametric studies off the same table.

# 11. Verification Tools

## 11.1 Interference Detection

Tools → Interference Detection, run it at each configuration (Closed / Mid / Full-open) and especially while dragging the Distance-Limit mate through its full range — this is where a too-thin sleeve wall or an under-sized bushing clearance shows up before it becomes a manufactured part that doesn't fit.

## 11.2 Motion Study (SolidWorks Premium)

Animate the actuator driving the rod through a full throttle cycle using the Distance mate as the motor. Useful for a quick visual sanity check of travel range and for producing a demonstration animation; not a substitute for the interference check above.

## 11.3 Flow Simulation

Setting | Value
Local mesh refinement | At the annular gap and vane surfaces
Minimum cell size | 0.05 mm (≈10 cells across the 0.5 mm gap)
Boundary layer mesh | First cell height ≈0.01 mm, growth ratio 1.2, 5 layers
Total cell count | 2–5 million for a 90° sector (use periodic/rotational symmetry where possible)

What to plot, in this order:

1. Velocity vectors at the annular exit plane — look at circumferential variation directly.
2. Swirl number S vs. θ — should approach zero downstream of the vanes.
3. Mass flux uniformity — target ṁ(θ) constant within ±5%.
4. Pressure contour — should be roughly axisymmetric after the vanes.

NOTE — Run the BASELINE (PI-003B) first and confirm it shows strong swirl and asymmetric flux before trusting a spiral+vane result — if the baseline looks clean, your mesh/BCs are wrong, not your spiral design good. Also, restrict CFD conclusions to TMR > 0.74 where steady RANS is known to hold; the MDPI 2026 study found steady RANS overpredicts spray angle by up to 62% below that, so low-throttle CFD needs unsteady RANS or LES.

## 11.4 Dimension Sensors

FeatureManager → Sensors → Add Sensor → Dimension. Add one on the annular gap (tag) so SolidWorks flags automatically if a design change ever drives it toward zero or negative, and one on the rod-bore wall thickness (PI-001) so a future Dp/Dt change can't silently create an unmachinable wall.

# 12. SolidWorks Drawings

## 12.1 Per-part drawings

Insert → Drawing for each part, standard 3-view + isometric layout, with a title block matching your lab/course template. Cross-reference the companion PDF's Notes blocks for each part when filling in tolerances, material callouts, and surface finish — those sheets were written to hand directly to a SolidWorks drawing, not just to a modeler.

## 12.2 Family-of-positions drawing (assembly)

Insert → Drawing, pull the SAME assembly view in three times on one sheet, switching each view's configuration to Closed / Mid-throttle / Full-open — this is the standard way to show a movable pintle's full travel range on a single sheet without three separate files.

# 13. Assumptions & Open Items Carried Into This CAD

Every geometry choice here traces back to either the METU thesis baseline, the project's MATLAB feasibility script, or an explicit packaging/manufacturing placeholder. Table below is the single place to check before treating any dimension as final.

Item | Status | Where flagged
Dt, Dp, alpha, tag, tpg (core pintle geometry) | Validated baseline (METU Type-1, tested at design point O/F=4) | Thesis Table 3.1
Design point reused at O/F=3.2 instead of O/F=4 | Reasonable but not identically validated — geometry borrowed, flow condition changed | Conversation log Sec.5
Sleeve bore = straight cylinder, not cone-following | First-pass simplification, refine after CFD if needed | This guide, Sec.3
R_spiral_start=25, R_spiral_end=15 | Packaging PLACEHOLDER — not derived from mass flow or channel size | Ref. doc Sec.6.6 / review log
5% area floor (A_min) at θ=360° | Deliberate fix for a real zero-area singularity, not arbitrary | MATLAB v2 script Sec.6
Vane loss coefficient K≈0.1–0.3, vane count=12 | Placeholder, not CFD- or test-derived | Ref. doc Sec.6.4
Weber number formula uses sigma_CH4 (not sigma_LOX) | Corrected for liquid-liquid architecture; still a qualitative check only | Conversation log Sec.7
Boundary-layer formula (laminar flat-plate) | Conservative (overestimates δ) at the script's actual turbulent Re — safe direction, not a bug | Conversation log Sec.7
Channel height h=5.0 mm | Chosen to keep δ/h < 0.3 per scale-effect gate | Ref. doc Sec.6.2
O-ring, thread, and fastener sizes throughout | Reasonable placeholders — verify against real hardware before ordering | This guide

None of this CAD replaces CFD (SolidWorks Flow Simulation) or cold-flow testing — both remain required before treating the spiral+vane concept as validated, per the project's own master checklist.

Pintle Injector — SolidWorks Modeling Guide
