prathiitsharma-cmd/Pintle-Injector-Re-Design/docs/design-guide/reference-images/pintle-sleeve-tip-ring/README.md

# Pintle sleeve / tip ring reference images

No reference images have been added for this part yet (mirrors the empty `Pintle Sleeve and Tip Ring` folder from the original project files). Add images here as they're gathered.
