prathiitsharma-cmd/Pintle-Injector-Re-Design/docs/design-guide/reference-images/pintle-rod/1.png

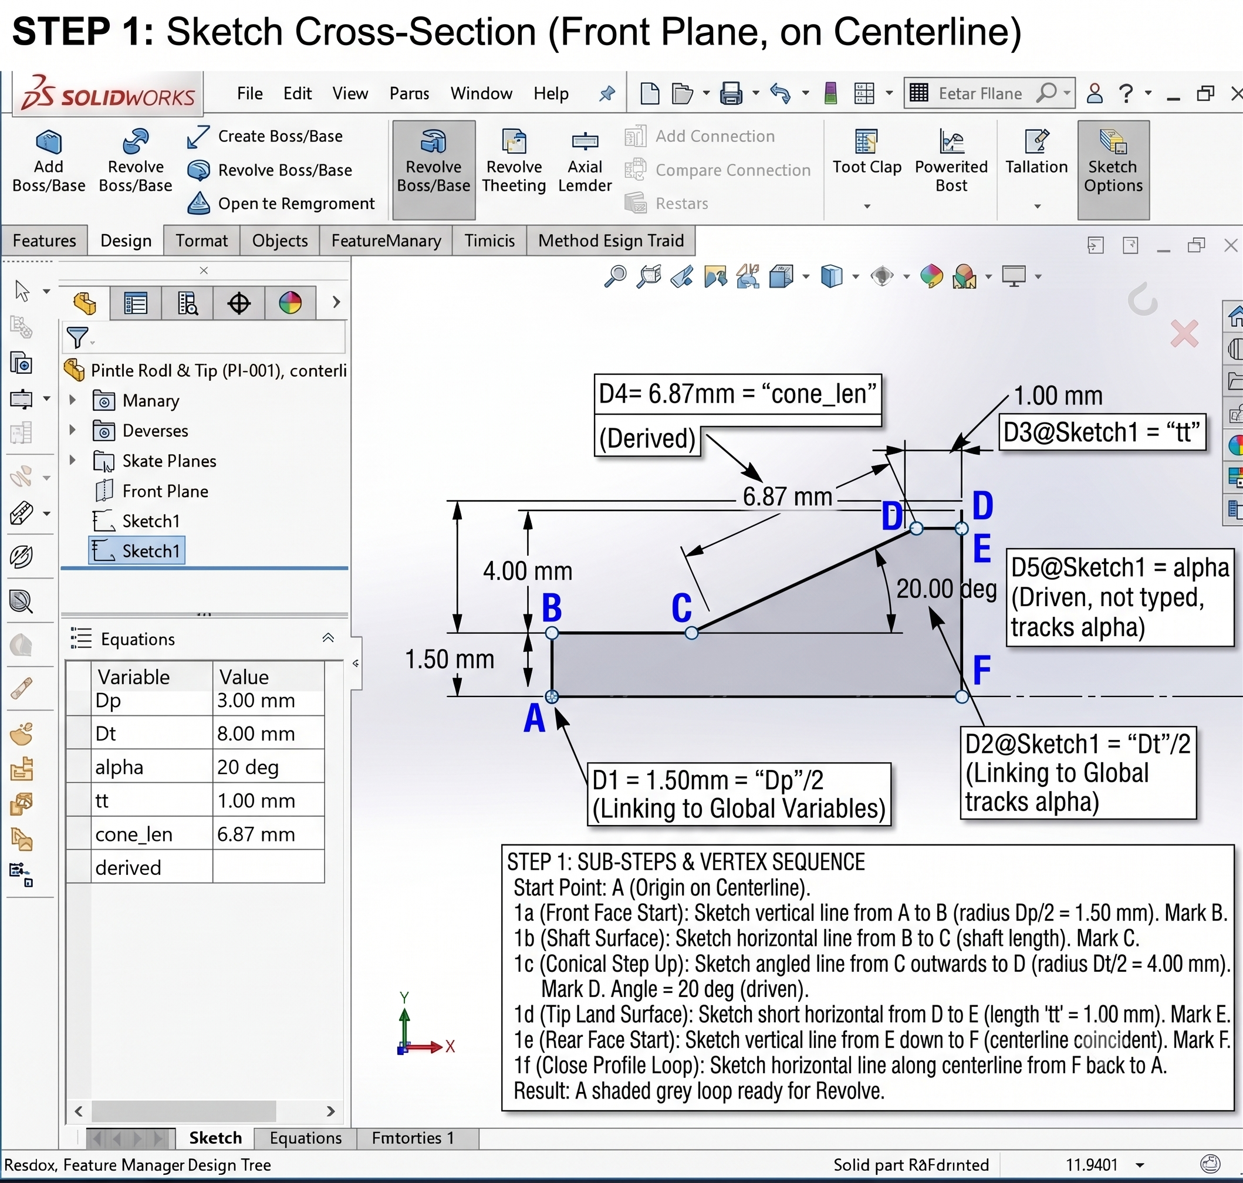
docs/design-guide/reference-images/pintle-rod/1.png
