prathiitsharma-cmd/Pintle-Injector-Re-Design/docs/design-guide/reference-images/pintle-rod/4.png

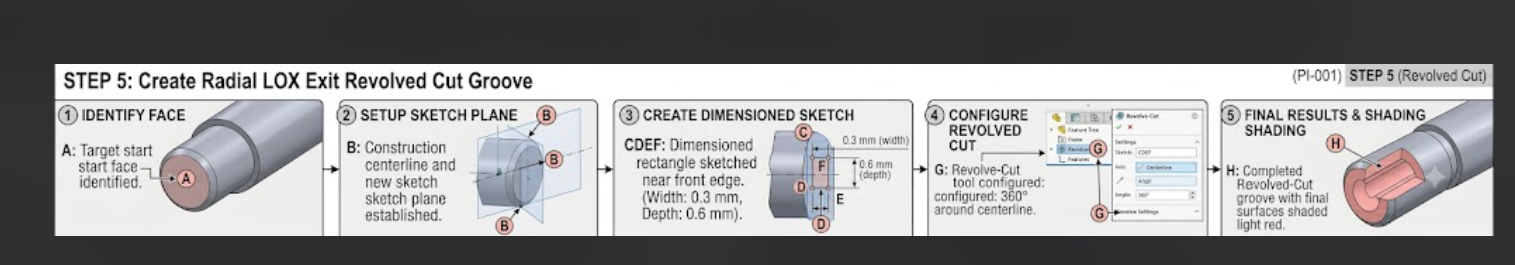
docs/design-guide/reference-images/pintle-rod/4.png
