prathiitsharma-cmd/Pintle-Injector-Re-Design/docs/design-guide/reference-images/pintle-rod/6.png

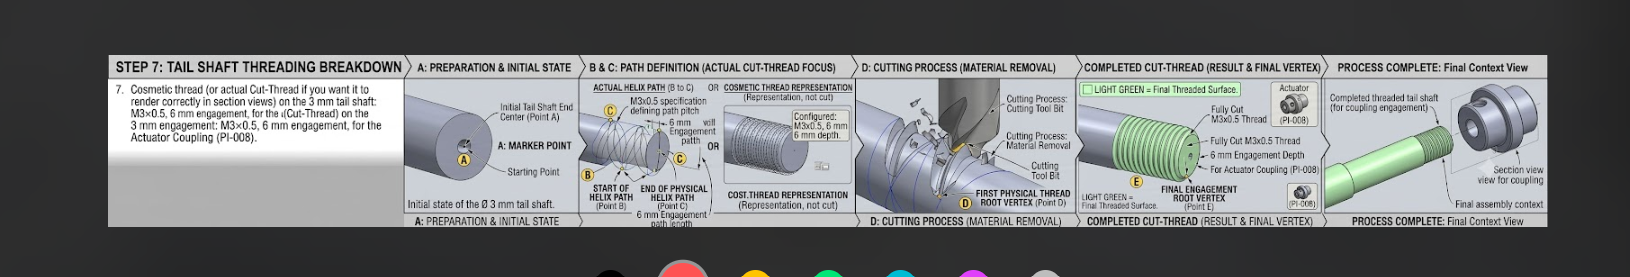
docs/design-guide/reference-images/pintle-rod/6.png
